Rutherfurrd/Science-Jubilee-Modular-Equipment-System/Todo.txt

Jubilee Presentation:
-3D print control hub housing
-Mill hotplate blanks
-Prep small demo

-Add fan to H&S, 20mm
-Remodel all of H&S
-Refine hotplate
-Finish PCB's
