Rutherfurrd/Science-Jubilee-Modular-Equipment-System/Presentations/Design Review 5-7.pptx

## Heating and Stirring Module Design Review #5

## Heating & Stirring PCB

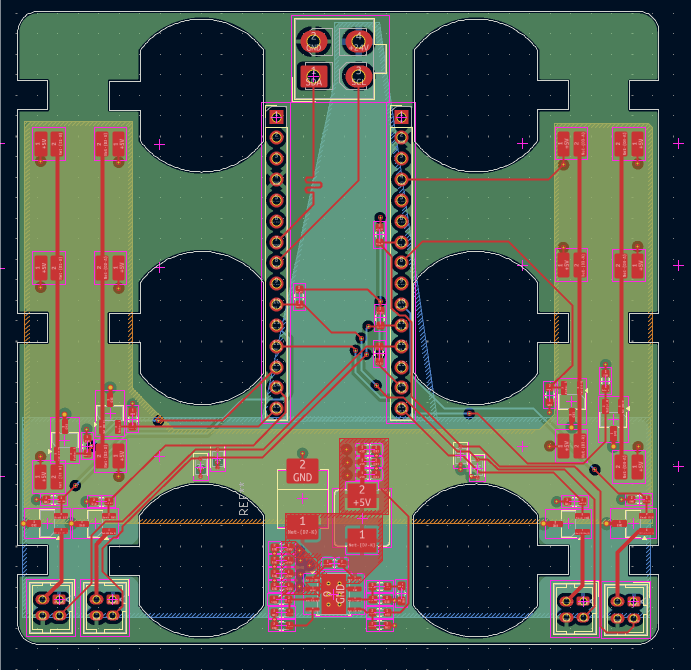
[picture p5: figure]

- Finished routing 4-layer board
- Mainly SMD components, to be assembled by hand
- Designed around NUCLEO-G431KB Development board
- $7 order, 5 board MOQ.

## Heating & Stirring PCB

- Slides directly over motor housing.
- Motor housing requires alteration to account for connector placement.
- Solder pads for motor connection limits repairability, lowers cost.
- Ventilation?
- EMI Concerns

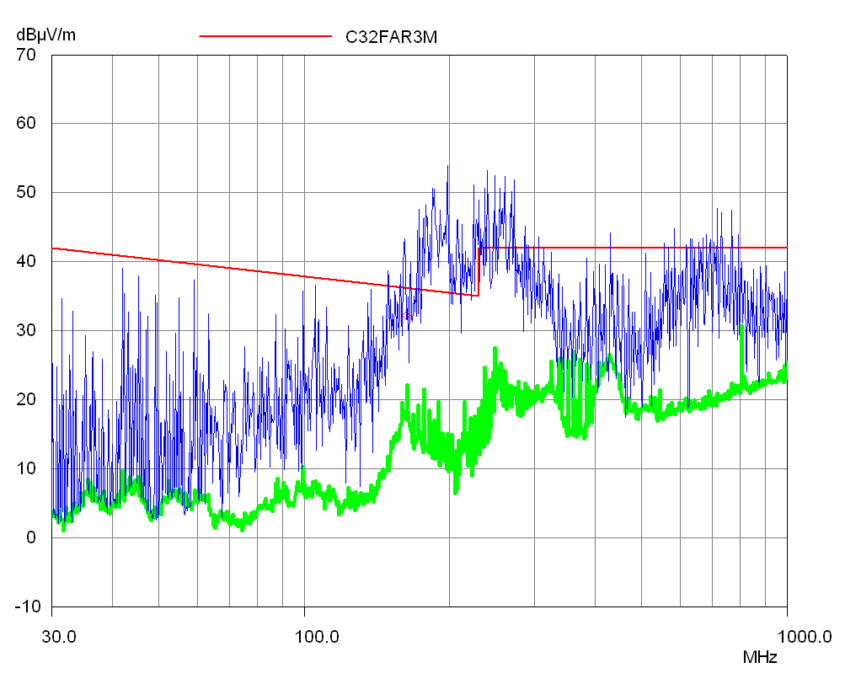
[picture p6: figure]
rf - DC brush motor EMI - Electrical Engineering Stack Exchange
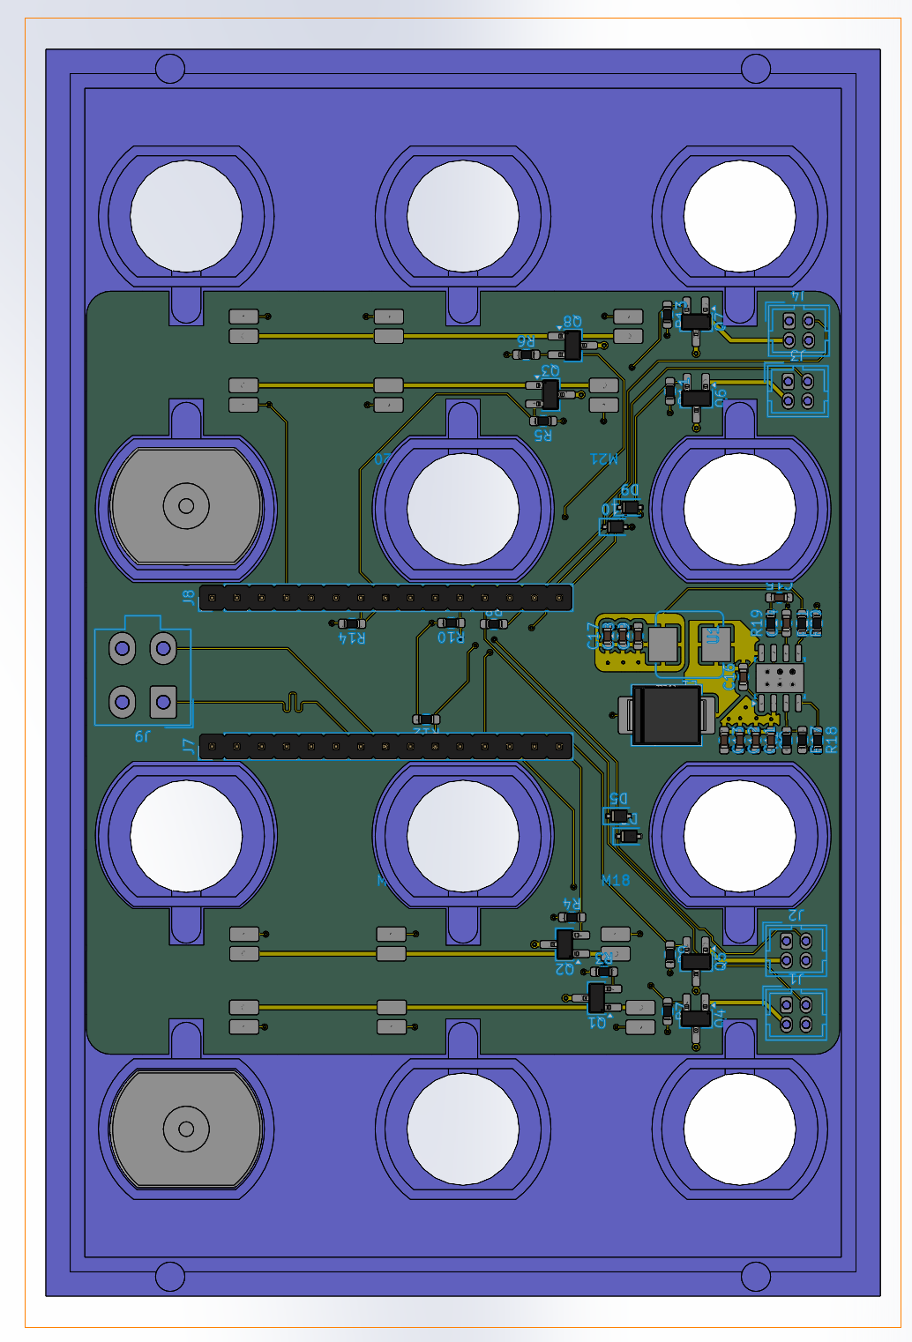
[picture p7: figure]

## Control Hub PCB

- Based on NUCLEO-C071RB development board.
- ~25A max draw, multi-plane power bus.
- Limited power output, ~100W/module fully loaded.
- Fused main and module lines, emergency stop

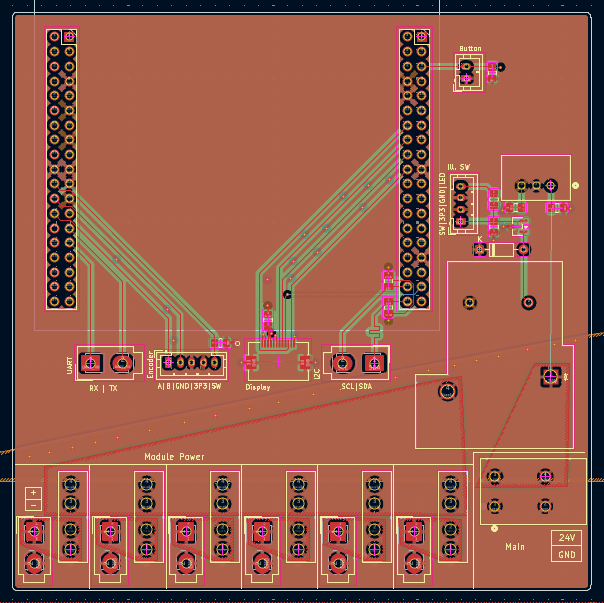
[picture p8: figure]

## Control Hub PCB

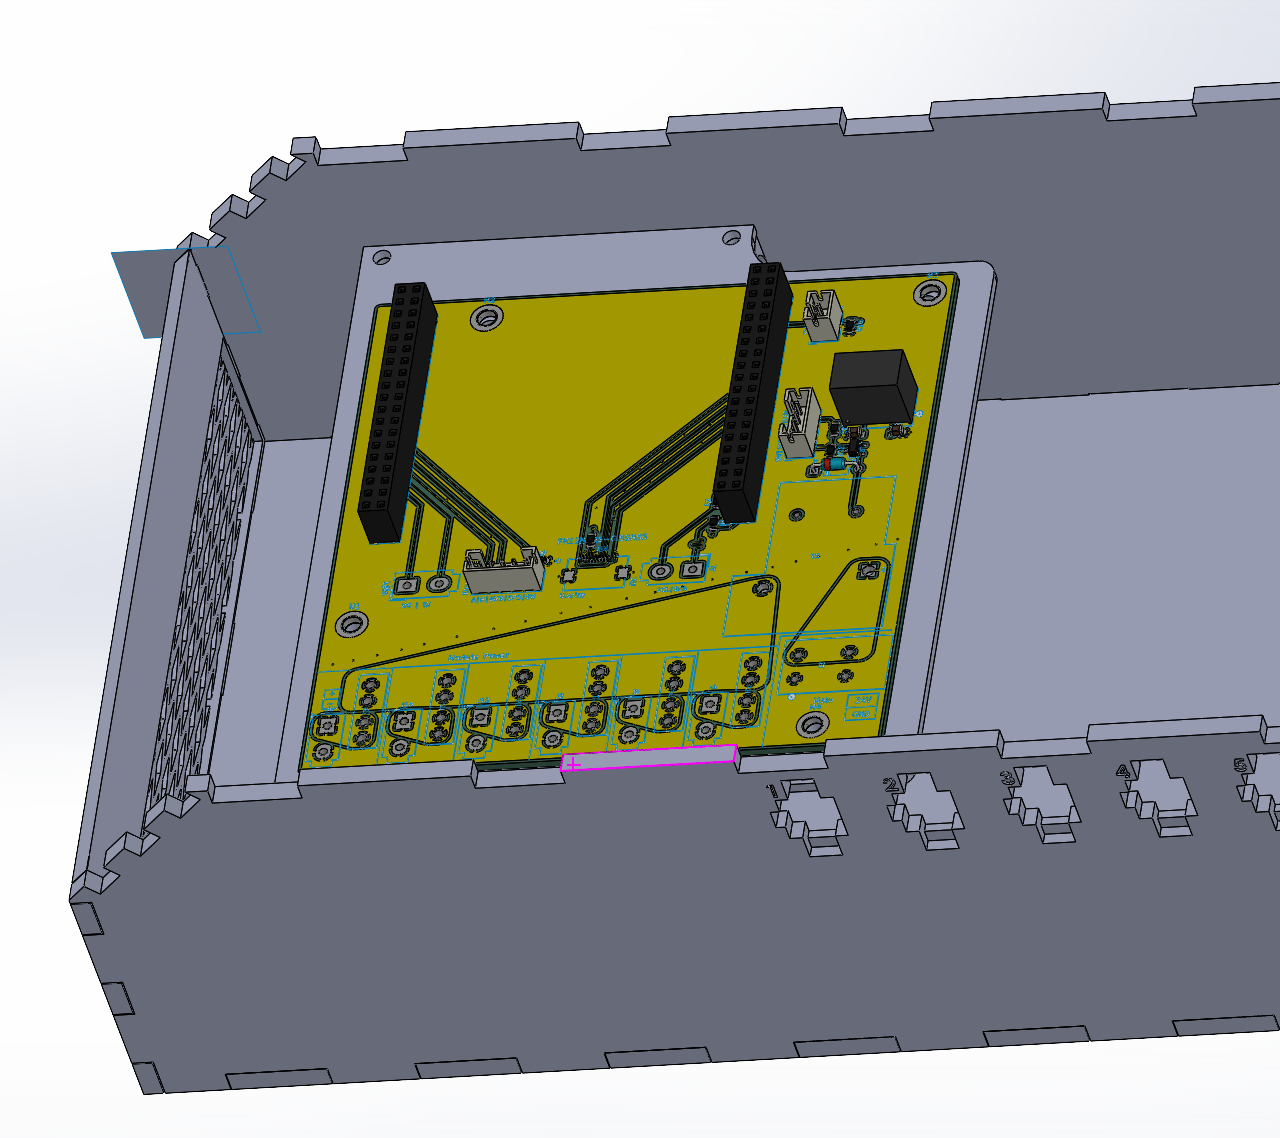
[picture p9: figure]

- Mounting plate, M3 screws + standoffs.
- Terminal-style main connection.
- MCU is over-spec, could be downsized to reduce footprint.

## CAN-Bus vs I2C

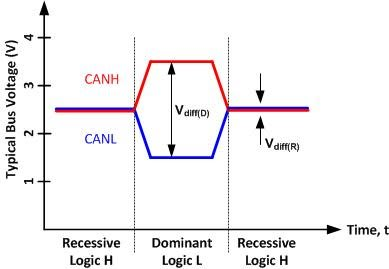
[picture p10: figure]
Introduction | CAN Bus Pt1 | DesignSpark

- H&S modules will be extremely noisy.
- I2C is noise sensitive, resulting in packet loss.
- CAN-Bus is noise resistant by nature.
  - Requires extra IC.
  - Reduces connector positions.
  - Modules can be “chained” together.
  - Slightly slower transmission speeds, negligible in our case.

CAN-BUS Timing Diagram

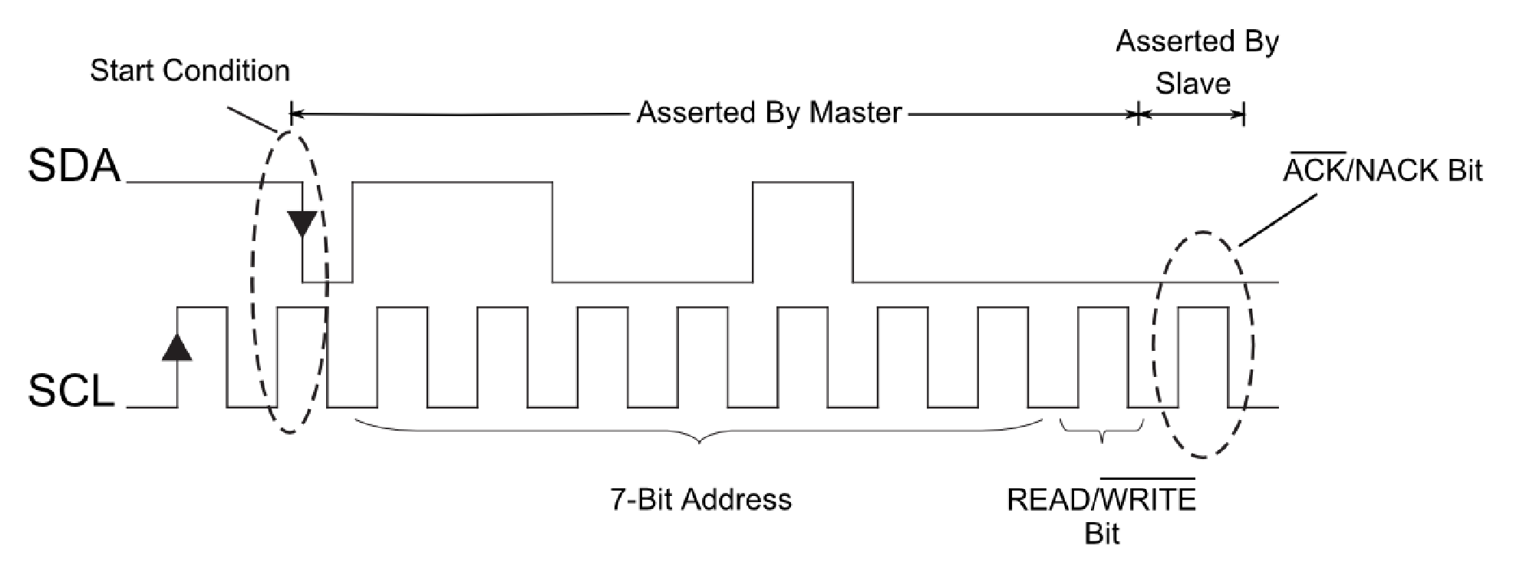
[picture p11: figure]
I2C Primer: What is I2C? (Part 1) | Analog Devices

I2C Timing Diagram

## Next Steps

- Implement CAN-Bus.
  - CAN Transceivers
  - Hot-swappable terminating resistors
- Alter housing to account for PCB changes.
  - Ventilation
  - Connector sizing
  - Button/Screen placement
- Verify high-current design with experienced peers.
