Rutherfurrd/Science-Jubilee-Modular-Equipment-System/Presentations/Design Review 4-16.pptx

## Heating and Stirring Module Design Review #4

## Power Constraints

- Underestimated power requirement of hotplates.
  - 10-25W required, 5W initial estimate.
  - Further testing required.
  - Total power consumption, 450-700W.
- Change from 5V to 24V architecture.
  - Lower transmission losses.
  - Lower current.
  - Requires redesign of current power distribution systems.

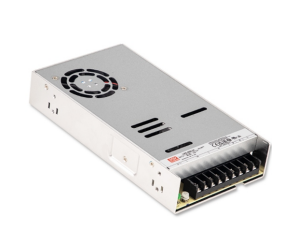
[picture p12: figure]

## Power contd.

- Larger power supply required, increased cost.
  - LRS-600N2, 600W @ 24V, $64. 12% larger footprint.
  - Cannot accommodate a 6-module control hub, 4 at most.
- H&S 24-5V Buck required, increased complexity.

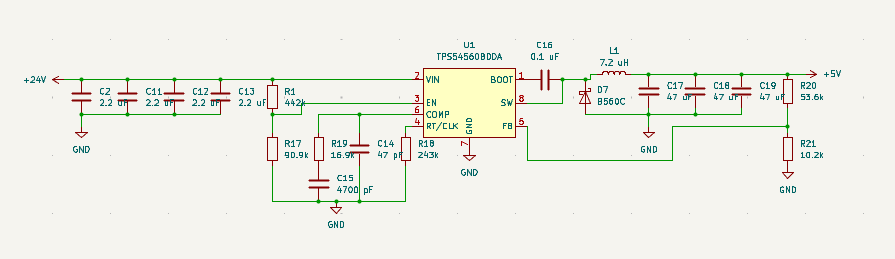
[picture p13: figure]

## Redesigned Hotplate

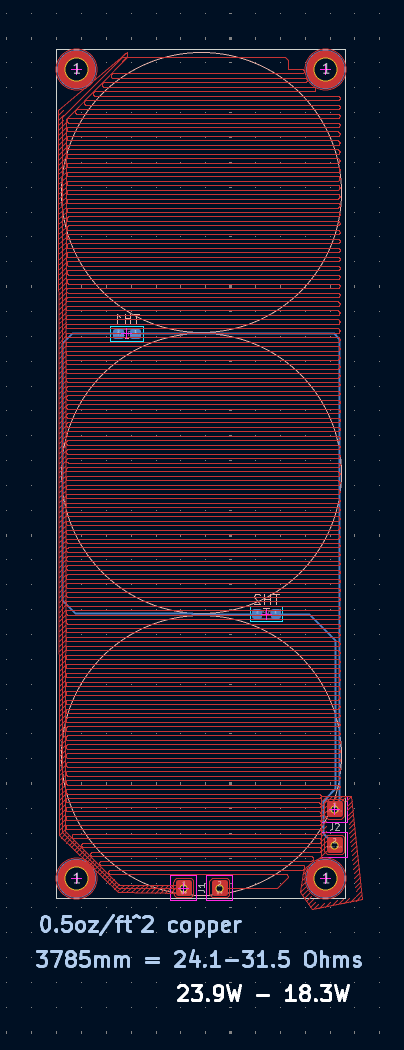
[picture p14: figure]

- Tuned line thickness, routing pattern for:
  - Higher resistance.
  - Output power, 25W goal.
  - Heat dissipation.
  - Thermistor accuracy.

## Adjusted Housing Dimensions

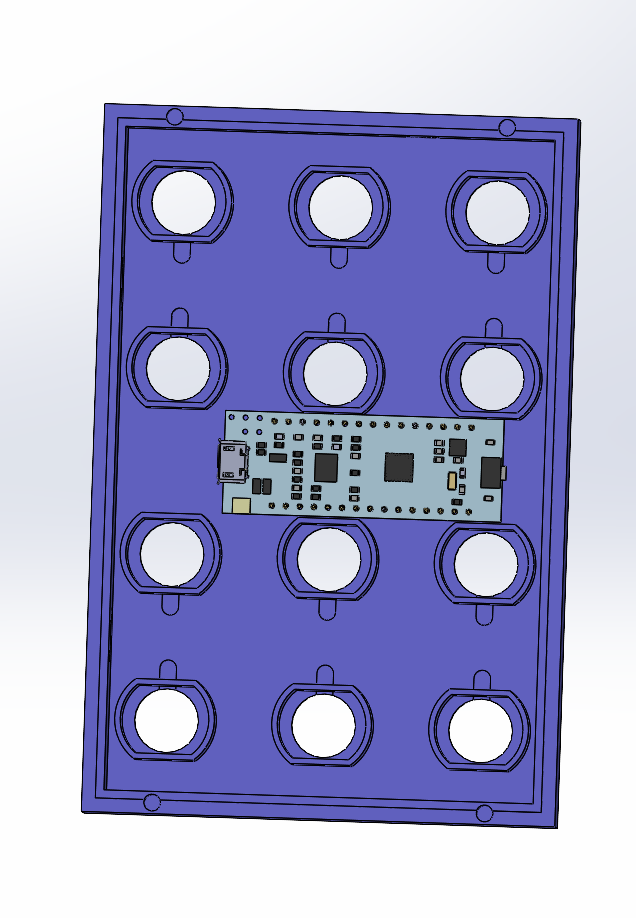
[picture p15: figure]

- Altered motor spacing to accommodate for a Nucleo-32 development board.
- Reduced complexity.
- All housing components must be updated.

## Heating and Stirring PCB

- 75% complete, missing pinouts, several connectors.
- 4-layers, assembled by hand.
- SMD components unavoidable.
- Redesigned power distribution.
  - 24V, 1A hotplate. Main bus.
  - 5V, ~3A total motors. Buck converter.
  - 3.3V, ~400mA logic. Internal LDO VR.

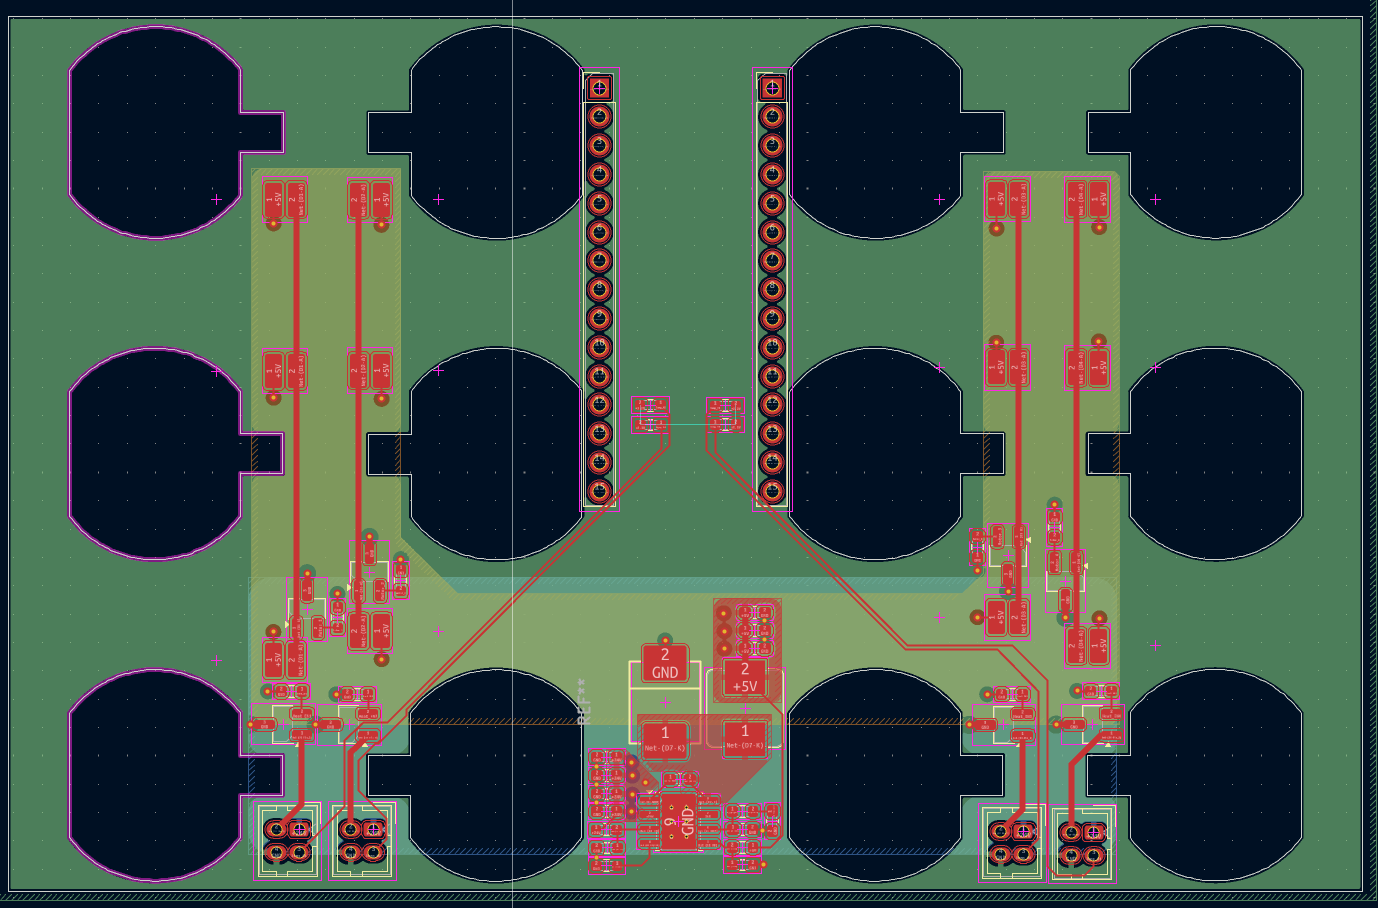
[picture p16: figure]

## Purchasing PCB’s

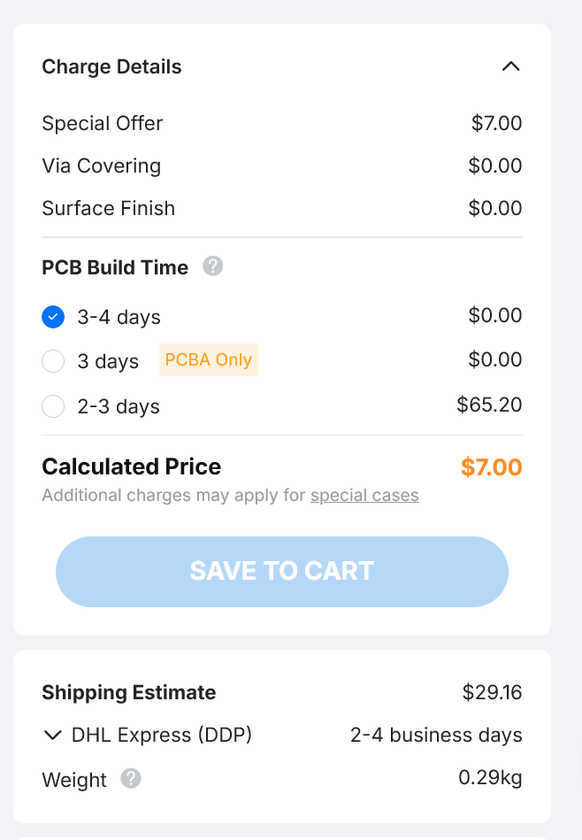
[picture p17: figure]

- Low materials cost
- Customs fee & tariffs ~$40
- Ordering in bulk
- Extensive testing prior to order

## Next Steps

- Finish H&S and Control Hub PCBs.
- Remodel H&S lid and vial guide.
- Remodel Control Hub.
- Test stir bar interaction.
