Rutherfurrd/Science-Jubilee-Modular-Equipment-System/Bill of Materials.xlsx

Sheet: H&S Module
Part | Serial | Link | Quantity | Price
Motor | PPN7PA12C1 | https://www.digikey.com/en/products/detail/nmb-technologies-corporation/PPN7PA12C1/2417079 | 12 | $3.29
Magnet | 9043 | https://www.digikey.com/en/products/detail/radial-magnets-inc/9043/6030788 | 24 | $0.38
Thermistor | ERT-J1VG103FA | https://www.digikey.com/en/products/detail/panasonic-electronic-components/ERT-J1VG103FA/526532
STM32 IO | Thermistor | 4
 | Heat MOSFET | 4
 | Motor mos | 7
 | UART | 2
Connectors
NUCLEO-L432KC (https://www.digikey.com/en/products/detail/stmicroelectronics/NUCLEO-L432KC/6132763)

Sheet: Control Hub
Display | https://www.digikey.com/en/products/detail/az-displays/ATM0130B3/12168269
Disp Conn | https://www.digikey.com/en/products/detail/hirose-electric-co-ltd/FH12-12S-0-5SH-55/1110374
Power Supply | LRS-200-5
AC Socket | DC11.0001.003 | https://www.digikey.com/en/products/detail/schurter-inc/DC11-0001-003/641544
Fan |  | https://www.digikey.com/en/products/detail/sunon-fans/MF40100V1-1000U-A99/6198732
2x2 Conn |  | https://www.digikey.com/en/products/detail/molex/0039012041/61227
USB |  | https://www.aliexpress.us/item/3256807073804695.html?gatewayAdapt=glo2usa
3-state SW |  | https://www.digikey.com/en/products/detail/adam-tech/SW-T2-2E-A-A2-M1/15284450
Switch |  | https://www.digikey.com/en/products/detail/e-switch/PS1024ARED/44577
Ill on/off SW |  | https://switches-sensors.zf.com/wp-content/uploads/2024/08/Rocker_SRB_Datasheet_2024-08-02.pdf
LED | 3mm diam

Sheet: Sheet2
Voltage (V) | 5
# of Modules | 6
 | Quantity | Component Current | Module Current | Module Power | Total Power
Motor | 12 | 0.235 | 2.82 | 14.1 | 84.6
Hotplate | 4 | 2.994011976 | 11.9760479 | 60 | 360
 |  |  |  | Total Power: | 444.6
 |  |  |  | Current: | 88.92
