Rutherfurrd/Science-Jubilee-Modular-Equipment-System/3D Files/Control Hub/Assembly/Assembly.SLDASM

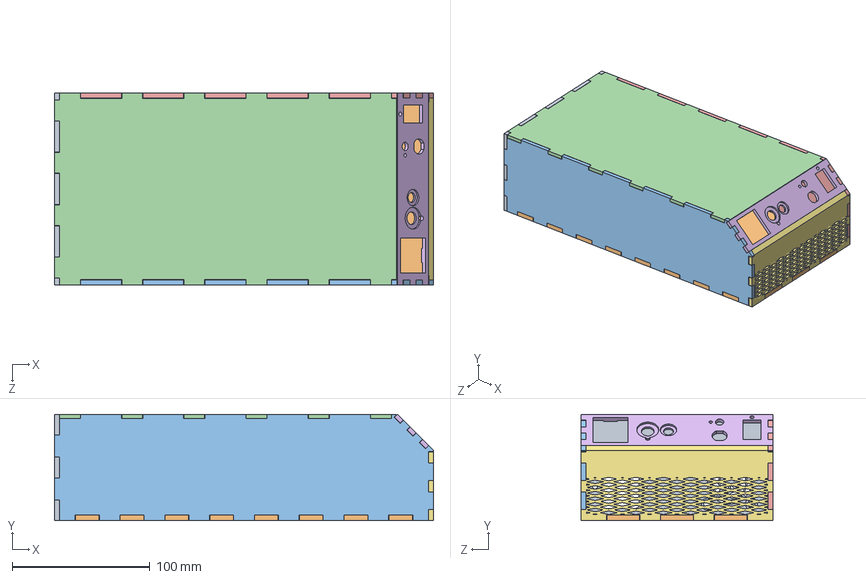
[picture p37: CAD file, 2026-05-28]
3D Files/Control Hub/Assembly/Assembly.SLDASM
275.0 x 77.2 x 139.0 mm
Tab and Slot-Tab20
Boss-Extrude11
Tab and Slot-Slot19
Tab and Slot-Tab21
Tab and Slot-Slot20
Tab and Slot-Slot11
Tab and Slot-Slot21
