Rutherfurrd/Science-Jubilee-Modular-Equipment-System/3D Files/Control Hub/Assembly/Tab and Slot-Slot21.SLDPRT

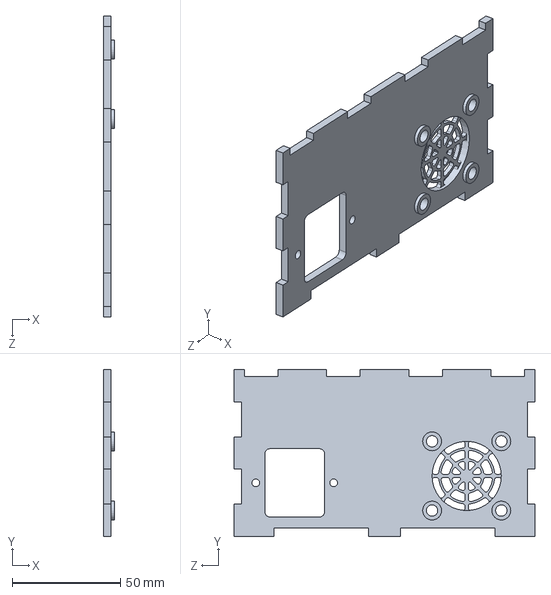
[picture p38: CAD file, 2026-05-28]
3D Files/Control Hub/Assembly/Tab and Slot-Slot21.SLDPRT
5.00 x 77.2 x 139.0 mm
