Rutherfurrd/Science-Jubilee-Modular-Equipment-System/3D Files/Control Hub/Print Files/Right Side Panel.STL

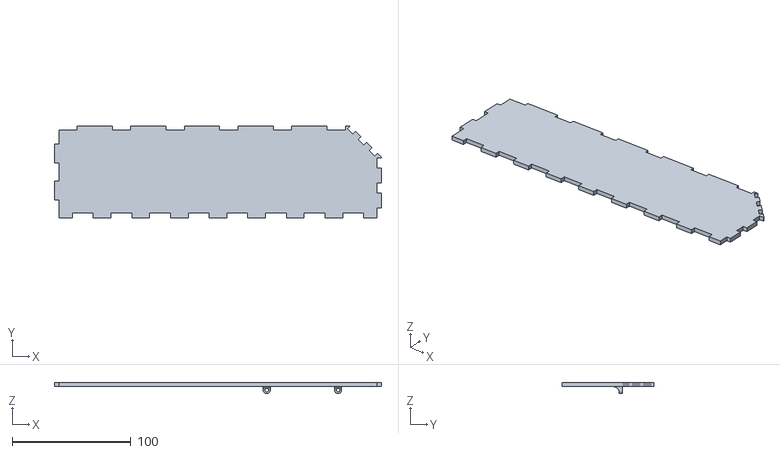
[picture p39: CAD file, 2026-05-28]
3D Files/Control Hub/Print Files/Right Side Panel.STL
275.0 x 77.2 x 9.50
