Rutherfurrd/Science-Jubilee-Modular-Equipment-System/3D Files/Control Hub/Tab and Slot-Slot19.SLDPRT

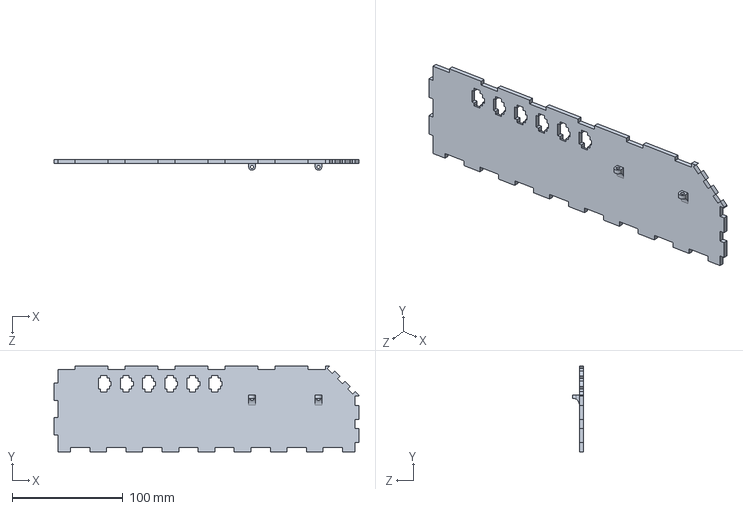
[picture p40: CAD file, 2026-05-28]
3D Files/Control Hub/Tab and Slot-Slot19.SLDPRT
275.0 x 77.2 x 9.50 mm
