Rutherfurrd/Science-Jubilee-Modular-Equipment-System/3D Files/H&S/Motor Base.SLDPRT

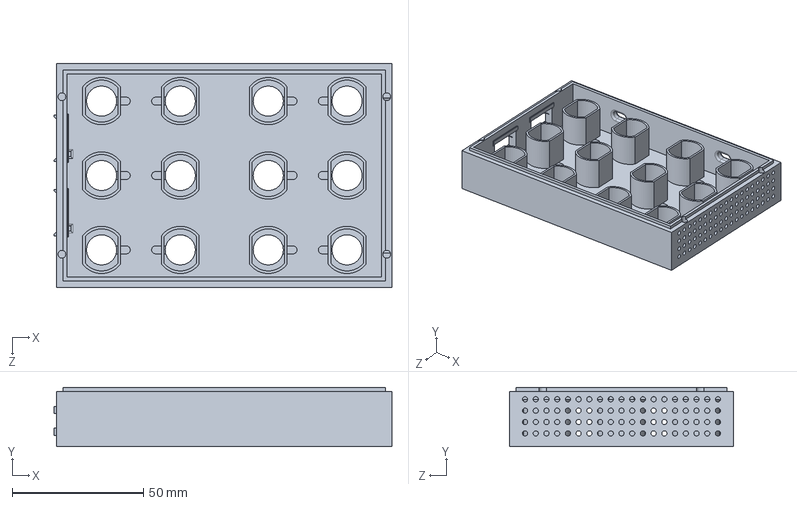
[picture p41: CAD file, 2026-05-28]
3D Files/H&S/Motor Base.SLDPRT
128.8 x 22.5 x 85.5 mm
