Rutherfurrd/Science-Jubilee-Modular-Equipment-System/3D Files/H&S/Print Files/Hotplate Stud.STL

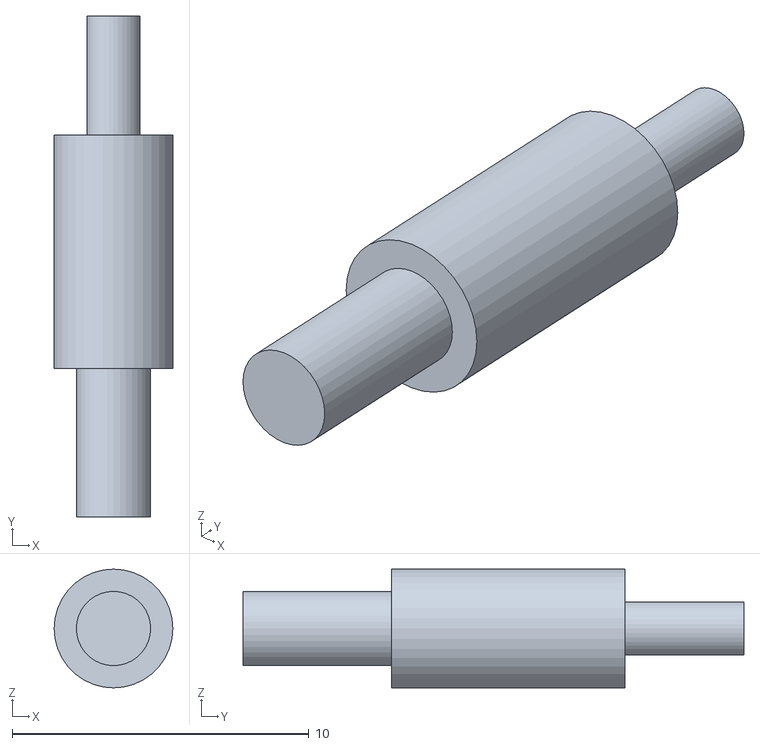
[picture p42: CAD file, 2026-05-28]
3D Files/H&S/Print Files/Hotplate Stud.STL
4.00 x 16.9 x 4.00
