Rutherfurrd/Science-Jubilee-Modular-Equipment-System/3D Files/Milling/PCB.step

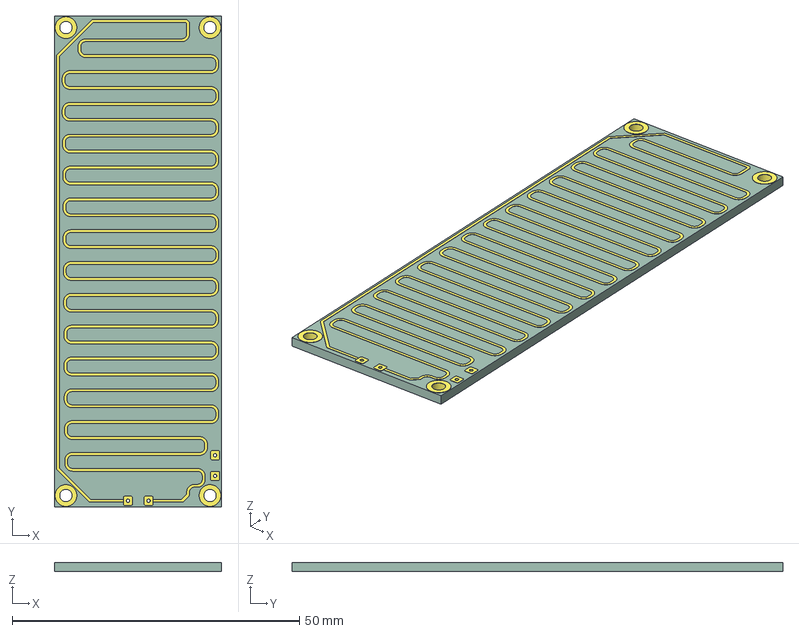
[picture p43: CAD file, 2026-05-28]
3D Files/Milling/PCB.step
29.1 x 85.5 x 1.59 mm
Heating board - Copy_copper
Heating board - Copy_pad
Heating board - Copy_PCB
