Rutherfurrd/Science-Jubilee-Modular-Equipment-System/Electrical Files/H&S Module/PCB.step

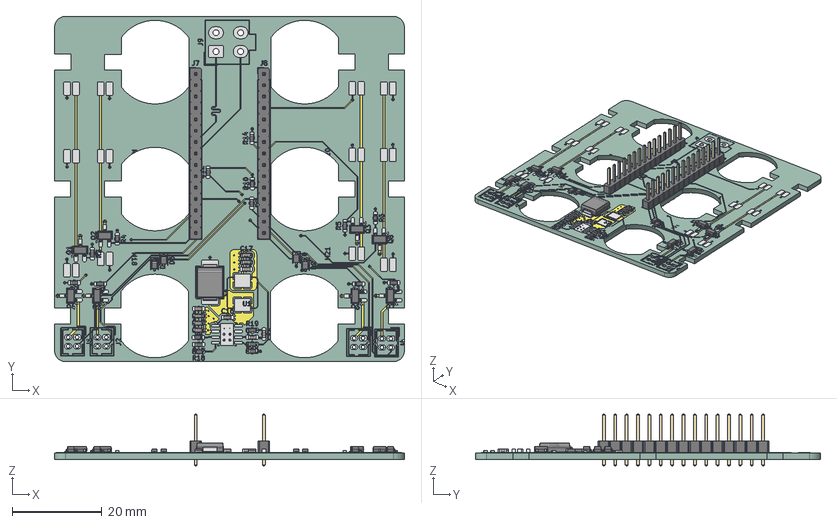
[picture p44: CAD file, 2026-05-28]
Electrical Files/H&S Module/PCB.step
78.2 x 77.2 x 11.5 mm
R_0603_1608Metric x 18
SC-59 x 8
SMC_L7.1-W6.2-LS8.1-R-RD
C_0603_1608Metric x 10
PinHeader_1x15_P2.54mm_Vertical x 2
D_SOD-323F x 4
S&H Management board_copper
S&H Management board_pad
S&H Management board_via
S&H Management board_silkscreen
S&H Management board_PCB
