Rutherfurrd/Science-Jubilee-Modular-Equipment-System/Electrical Files/Hotplate/Heating board.step

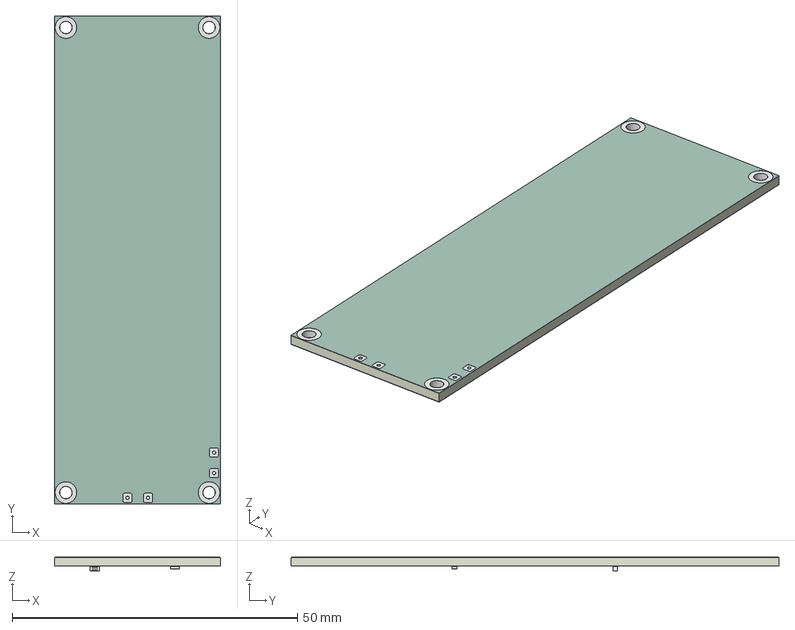
[picture p45: CAD file, 2026-05-28]
Electrical Files/Hotplate/Heating board.step
29.1 x 85.5 x 2.45 mm
C_0603_1608Metric
R_0603_1608Metric
Heating board_copper
Heating board_pad
Heating board_silkscreen
Heating board_soldermask x 2
Heating board_PCB
