Rutherfurrd/Science-Jubilee-Modular-Equipment-System/Electrical Files/Hotplate/JLCFH/JLC Stencil.DXF

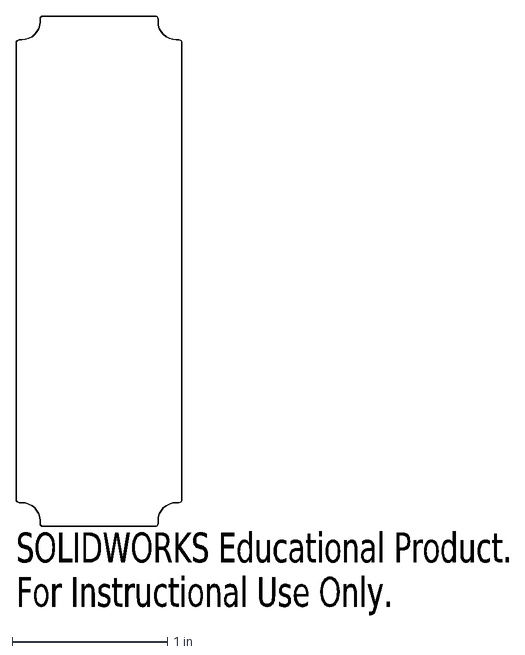
[picture p46: CAD file, 2026-05-28]
Electrical Files/Hotplate/JLCFH/JLC Stencil.DXF
SOLIDWORKS Educational Product.
For Instructional Use Only.
