Rutherfurrd/Science-Jubilee-Modular-Equipment-System/Electrical Files/PS Control Hub/PS Control Hub/PCB.step

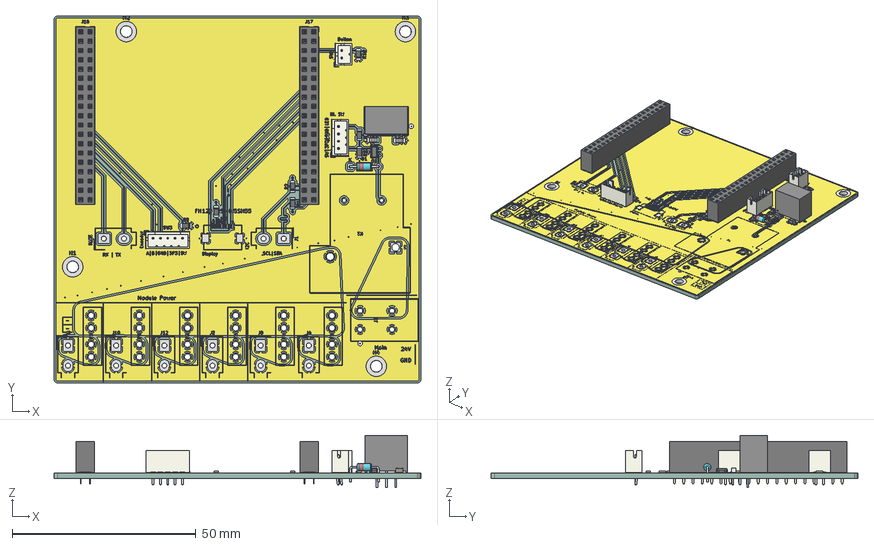
[picture p47: CAD file, 2026-05-28]
Electrical Files/PS Control Hub/PS Control Hub/PCB.step
100.0 x 100.0 x 14.3 mm
R_0805_2012Metric x 7
C_0805_2012Metric x 2
JST_PH_B4B-PH-K_1x04_P2.00mm_Vertical
JST_PH_B2B-PH-K_1x02_P2.00mm_Vertical
D_DO-35_SOD27_P7.62mm_Horizontal
SOT-23-3
JST_PH_B5B-PH-K_1x05_P2.00mm_Vertical
PinSocket_2x19_P2.54mm_Vertical x 2
TSR 1-2433E
PS Control Hub_copper
PS Control Hub_pad
PS Control Hub_via
PS Control Hub_silkscreen x 2
PS Control Hub_PCB
