Rutherfurrd/Science-Jubilee-Modular-Equipment-System/3D Files/H&S/Print Files/PCB - PCB.step-1 Heating board - Copy_PCB.step-1.STL

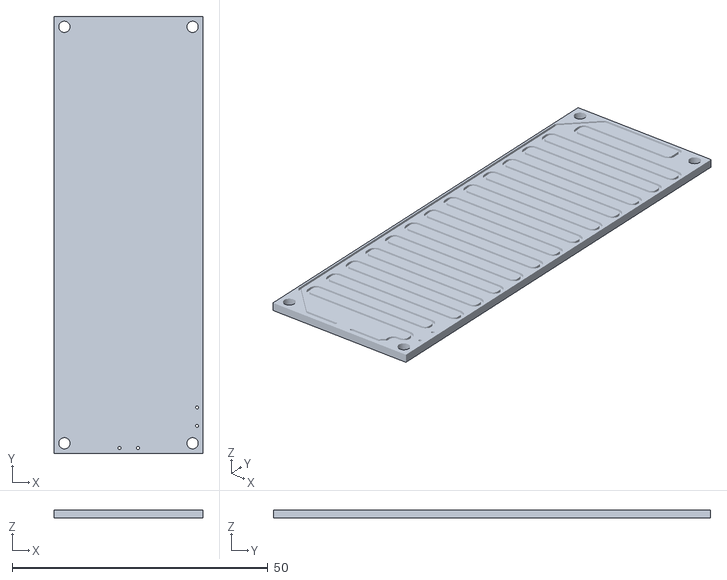
[picture p49: CAD file, 2026-05-28]
3D Files/H&S/Print Files/PCB - PCB.step-1 Heating board - Copy_PCB.step-1.STL
29.1 x 85.5 x 1.51
