Rutherfurrd/Science-Jubilee-Modular-Equipment-System/Electrical Files/H&S Module/Motor Base.DXF

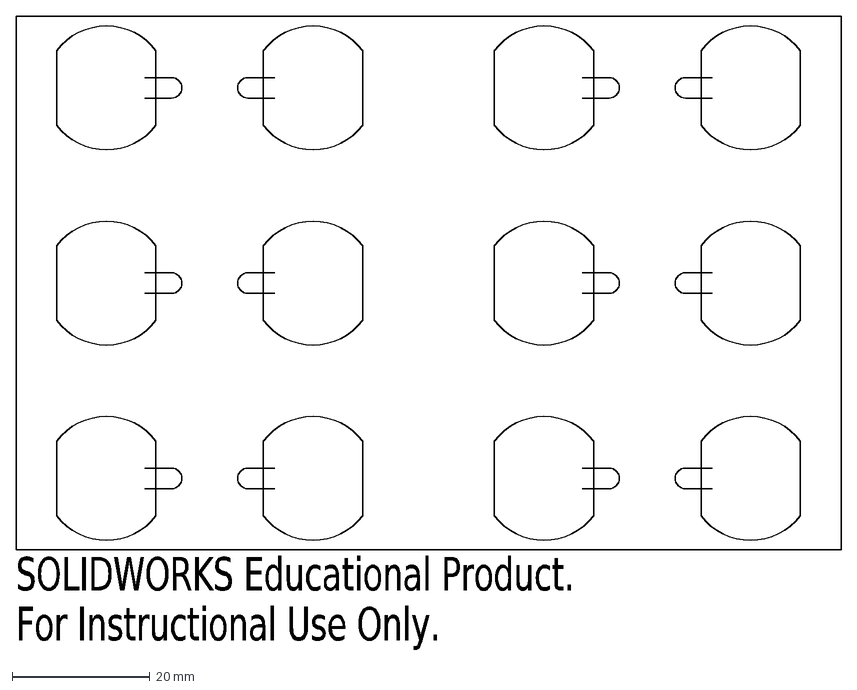
[picture p50: CAD file, 2026-04-16]
Electrical Files/H&S Module/Motor Base.DXF
SOLIDWORKS Educational Product.
For Instructional Use Only.
