Rutherfurrd/Science-Jubilee-Modular-Equipment-System/Electrical Files/Hotplate/JLCFH/JLC Step.step

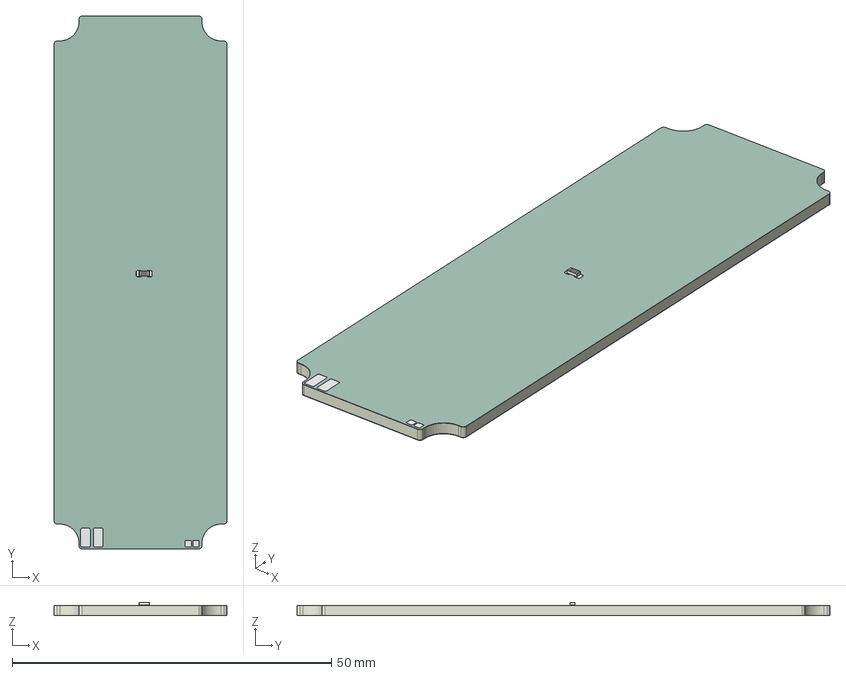
[picture p51: CAD file, 2026-05-28]
Electrical Files/Hotplate/JLCFH/JLC Step.step
27.1 x 83.5 x 2.09 mm
R_0603
Flexible Heater_pad
Flexible Heater_soldermask x 2
Flexible Heater_PCB
