Rutherfurrd/Science-Jubilee-Modular-Equipment-System/3D Files/Control Hub/Print Files/Button Interface.STL

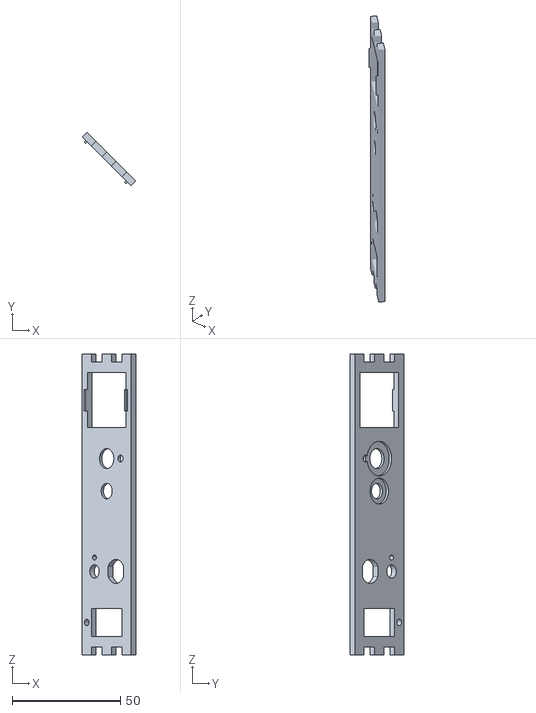
[picture p52: CAD file, 2026-05-28]
3D Files/Control Hub/Print Files/Button Interface.STL
24.7 x 24.7 x 139.0
