Rutherfurrd/Science-Jubilee-Modular-Equipment-System/3D Files/Control Hub/Tab and Slot-Tab21.SLDPRT

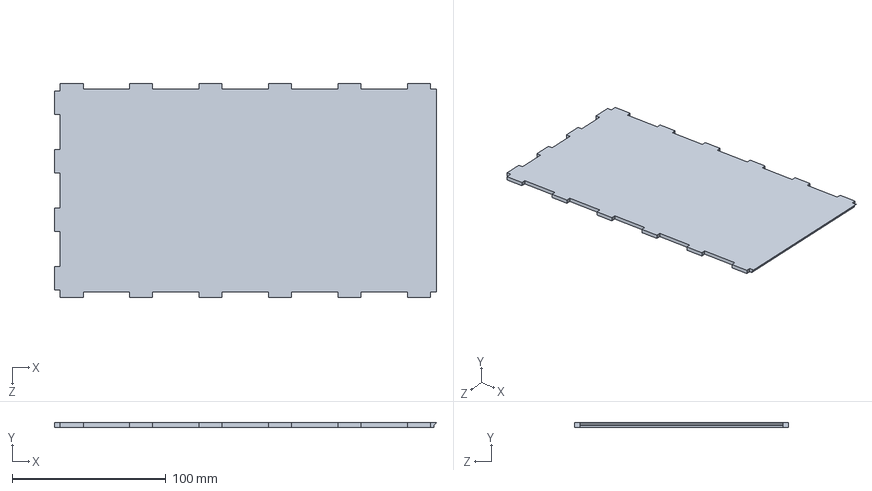
[picture p53: CAD file, 2026-05-28]
3D Files/Control Hub/Tab and Slot-Tab21.SLDPRT
248.2 x 3.00 x 139.0 mm
