Rutherfurrd/Science-Jubilee-Modular-Equipment-System/3D Files/H&S/Print Files/Test Well.STL

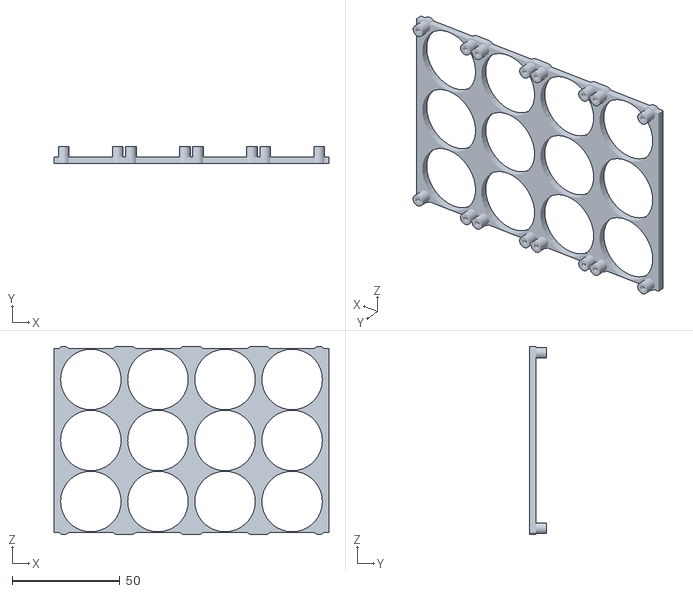
[picture p54: CAD file, 2026-05-28]
3D Files/H&S/Print Files/Test Well.STL
127.8 x 8.00 x 87.5
