Rutherfurrd/Science-Jubilee-Modular-Equipment-System/3D Files/Control Hub/Print Files/Front Grille.STL

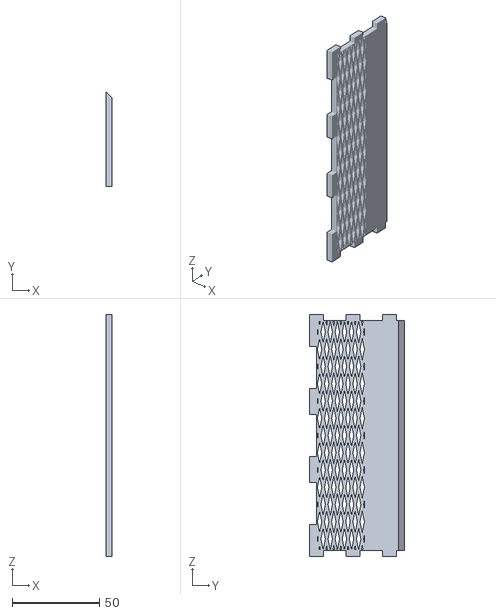
[picture p55: CAD file, 2026-05-28]
3D Files/Control Hub/Print Files/Front Grille.STL
3.50 x 54.5 x 139.0
