Rutherfurrd/Science-Jubilee-Modular-Equipment-System/3D Files/H&S/Magnet Case.SLDPRT

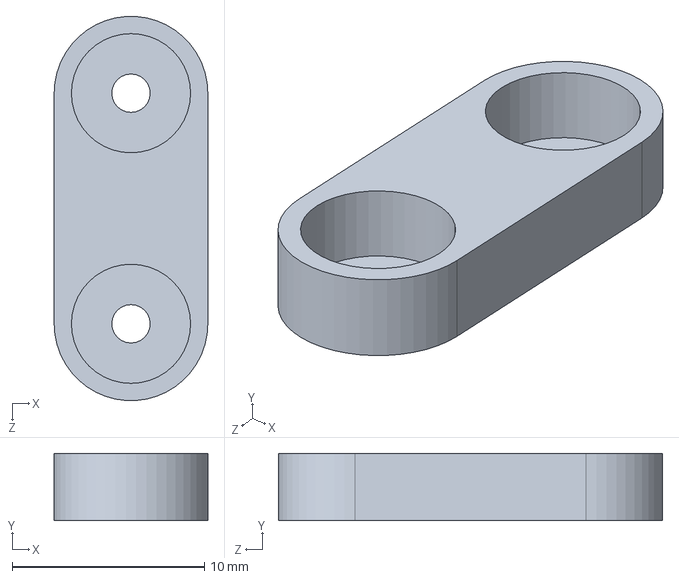
[picture p56: CAD file, 2026-05-28]
3D Files/H&S/Magnet Case.SLDPRT
8.00 x 3.50 x 20.0 mm
