Rutherfurrd/Science-Jubilee-Modular-Equipment-System/3D Files/H&S/Print Files/Test LID.STL

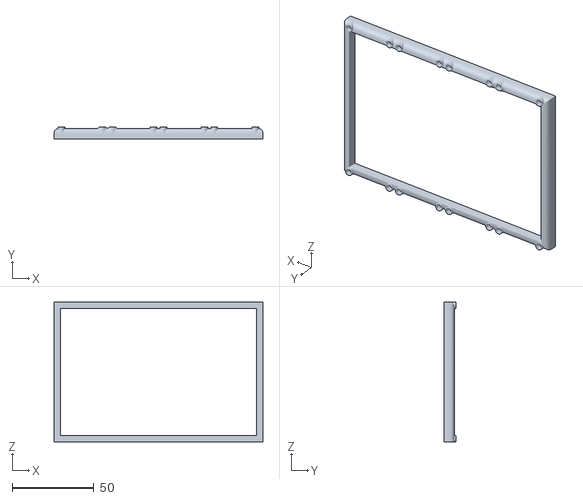
[picture p57: CAD file, 2026-05-28]
3D Files/H&S/Print Files/Test LID.STL
127.8 x 7.50 x 85.5
