Rutherfurrd/Science-Jubilee-Modular-Equipment-System/3D Files/Control Hub/Power Supply Chassis.SLDPRT

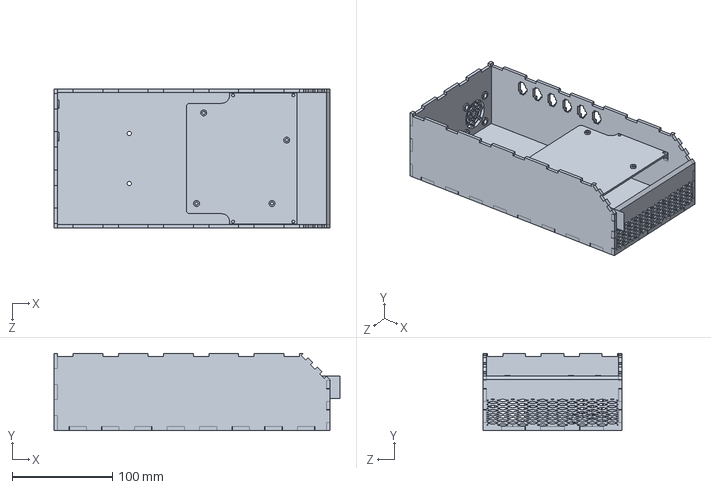
[picture p58: CAD file, 2026-05-28]
3D Files/Control Hub/Power Supply Chassis.SLDPRT
285.0 x 77.2 x 139.0 mm
