Rutherfurrd/Science-Jubilee-Modular-Equipment-System/3D Files/Control Hub/Print Files/Bottom Panel.STL

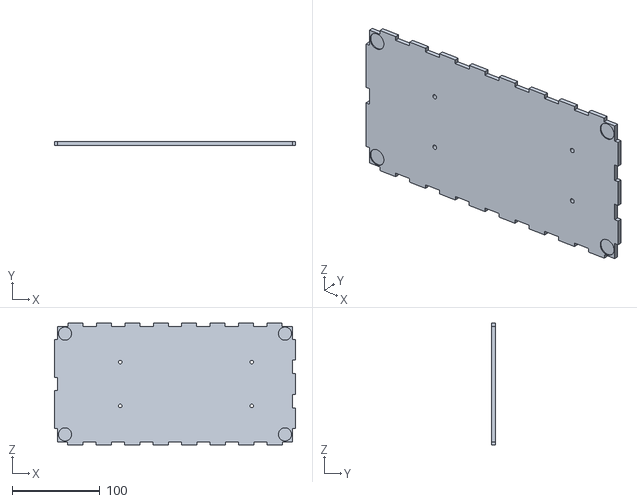
[picture p59: CAD file, 2026-05-28]
3D Files/Control Hub/Print Files/Bottom Panel.STL
275.0 x 4.00 x 139.0
