Rutherfurrd/Science-Jubilee-Modular-Equipment-System/3D Files/H&S/Print Files/PCB - PCB.step-1 Heating board - Copy_copper.step-1.STL

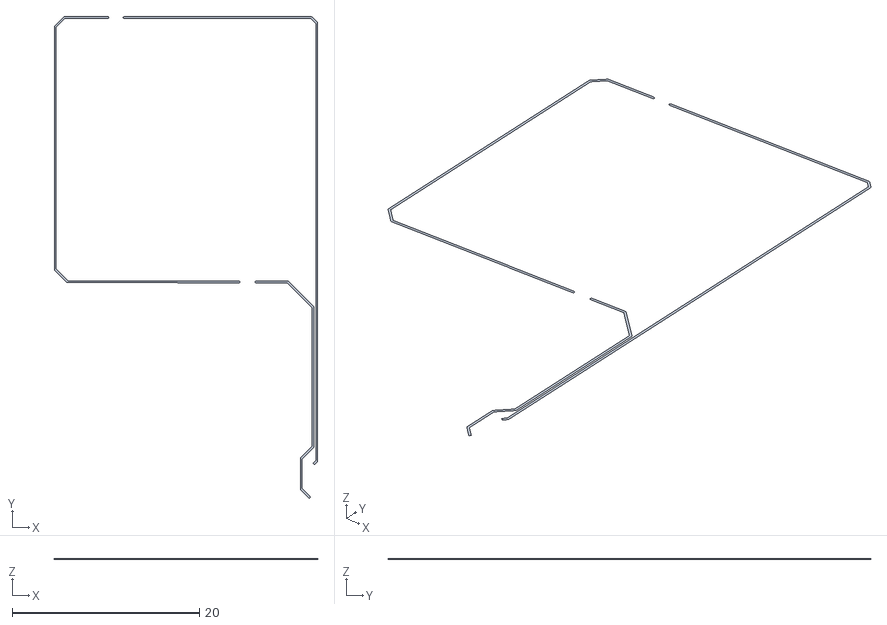
[picture p60: CAD file, 2026-05-28]
3D Files/H&S/Print Files/PCB - PCB.step-1 Heating board - Copy_copper.step-1.STL
28.1 x 51.4 x 0.035
