Rutherfurrd/Science-Jubilee-Modular-Equipment-System/3D Files/H&S/Print Files/PCB - PCB.step-1 Heating board - Copy_pad.step-1.STL

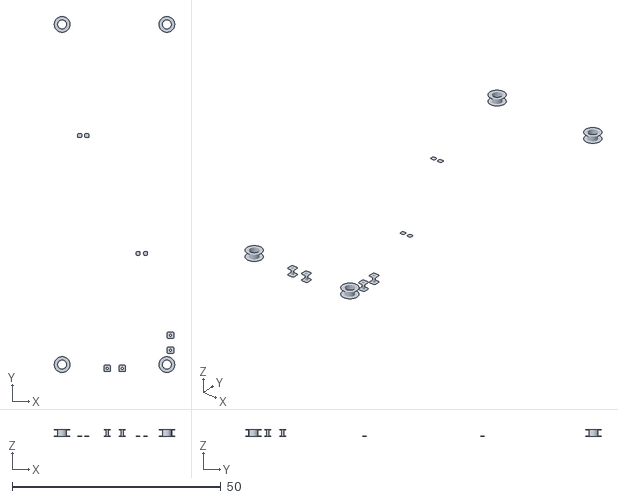
[picture p62: CAD file, 2026-05-28]
3D Files/H&S/Print Files/PCB - PCB.step-1 Heating board - Copy_pad.step-1.STL
28.9 x 85.3 x 1.59
