Rutherfurrd/Science-Jubilee-Modular-Equipment-System/3D Files/Control Hub/Tab and Slot-Slot11.SLDPRT

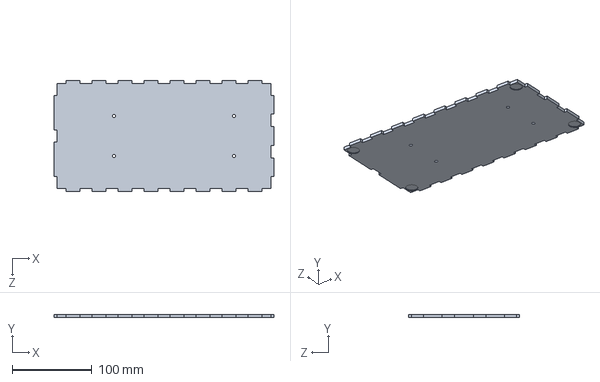
[picture p63: CAD file, 2026-05-28]
3D Files/Control Hub/Tab and Slot-Slot11.SLDPRT
275.0 x 4.00 x 139.0 mm
