Rutherfurrd/Science-Jubilee-Modular-Equipment-System/3D Files/Control Hub/Body2.SLDPRT

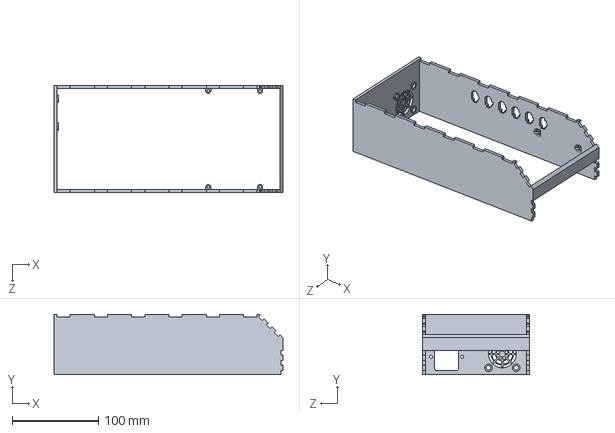
[picture p64: CAD file, 2026-04-16]
3D Files/Control Hub/Body2.SLDPRT
265.0 x 70.0 x 124.0 mm
