Rutherfurrd/Science-Jubilee-Modular-Equipment-System/3D Files/H&S/Motor.SLDPRT

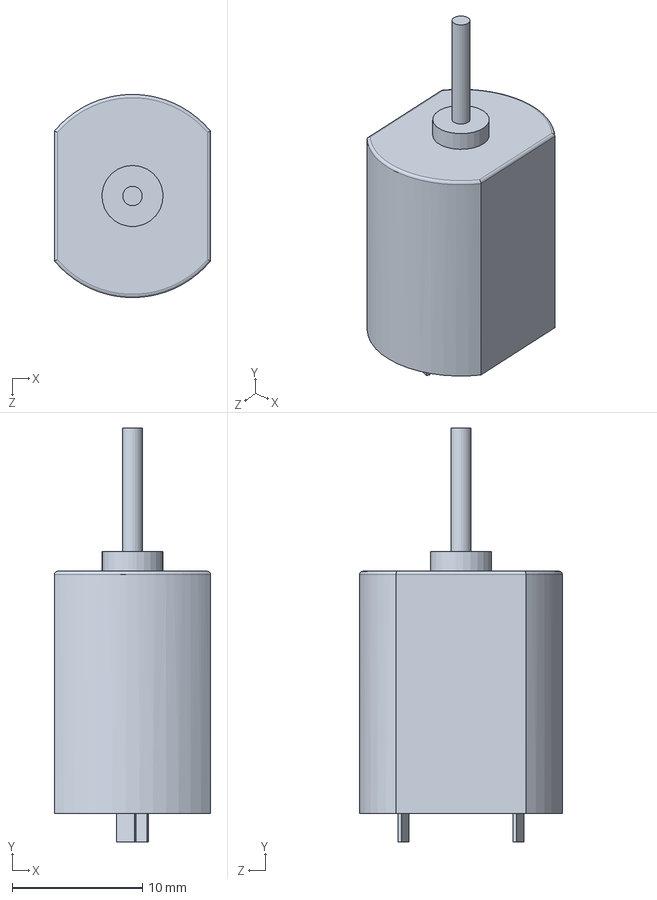
[picture p65: CAD file, 2026-03-10]
3D Files/H&S/Motor.SLDPRT
12.0 x 31.8 x 15.6 mm
