Rutherfurrd/Science-Jubilee-Modular-Equipment-System/3D Files/H&S/Magnet.SLDPRT

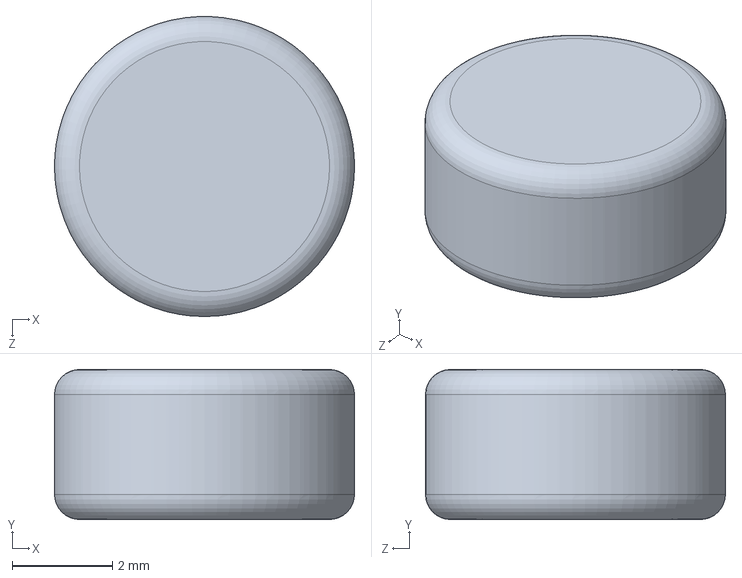
[picture p67: CAD file, 2026-03-10]
3D Files/H&S/Magnet.SLDPRT
6.00 x 3.00 x 6.00 mm
