Rutherfurrd/Science-Jubilee-Modular-Equipment-System/3D Files/Control Hub/Body1.SLDPRT

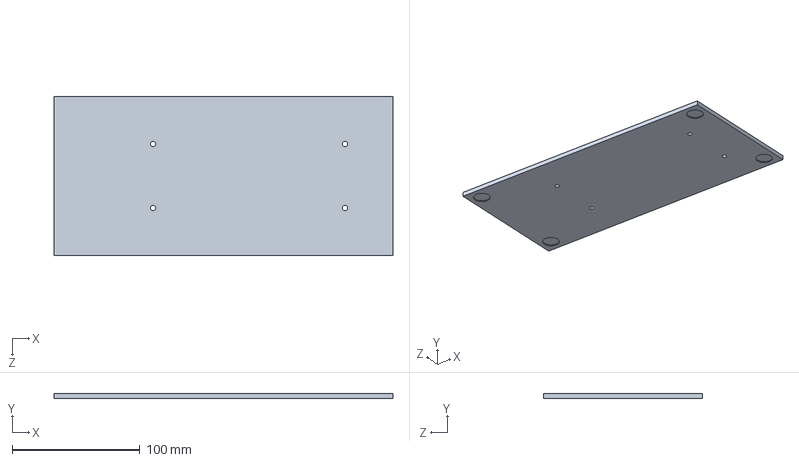
[picture p68: CAD file, 2026-04-16]
3D Files/Control Hub/Body1.SLDPRT
265.0 x 4.00 x 124.0 mm
