Rutherfurrd/Science-Jubilee-Modular-Equipment-System/3D Files/H&S/Heating pad.SLDPRT

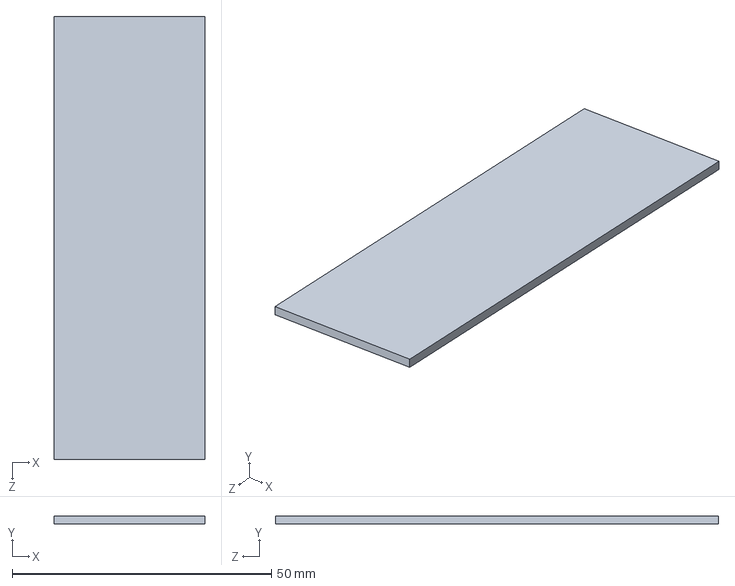
[picture p69: CAD file, 2026-03-10]
3D Files/H&S/Heating pad.SLDPRT
29.1 x 1.60 x 85.5 mm
