Rutherfurrd/Science-Jubilee-Modular-Equipment-System/3D Files/Control Hub/Body4.SLDPRT

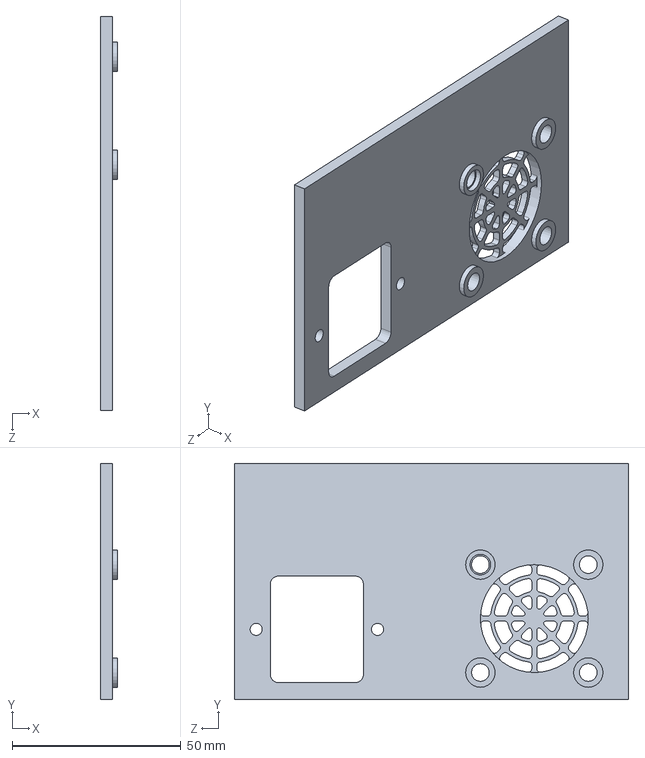
[picture p70: CAD file, 2026-04-16]
3D Files/Control Hub/Body4.SLDPRT
5.00 x 70.0 x 117.0 mm
