Rutherfurrd/Science-Jubilee-Modular-Equipment-System/3D Files/H&S/Motor Housing LID.SLDPRT

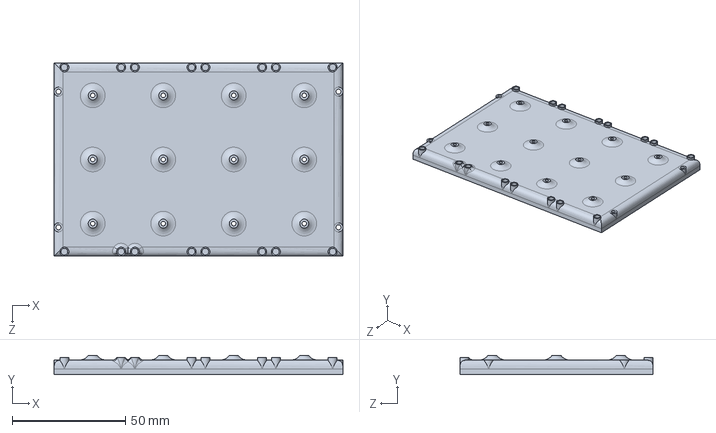
[picture p71: CAD file, 2026-03-10]
3D Files/H&S/Motor Housing LID.SLDPRT
127.8 x 8.50 x 85.5 mm
