Rutherfurrd/Science-Jubilee-Modular-Equipment-System/3D Files/Control Hub/Body9.SLDPRT

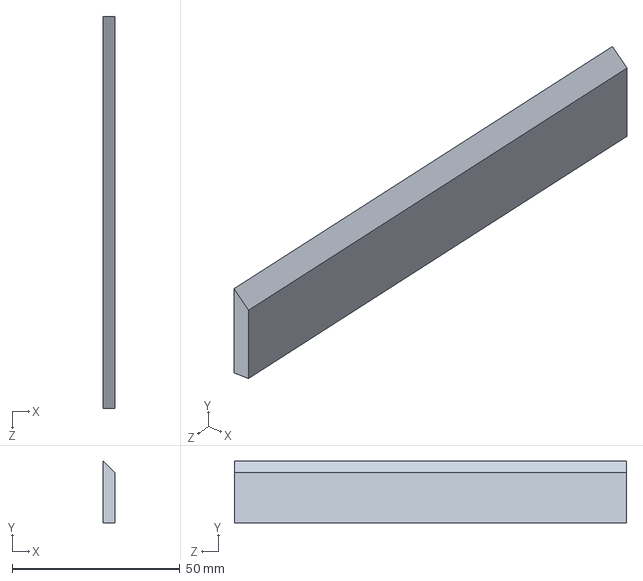
[picture p72: CAD file, 2026-04-16]
3D Files/Control Hub/Body9.SLDPRT
3.50 x 18.5 x 117.0 mm
