Rutherfurrd/Science-Jubilee-Modular-Equipment-System/3D Files/H&S/Vial Wells.SLDPRT

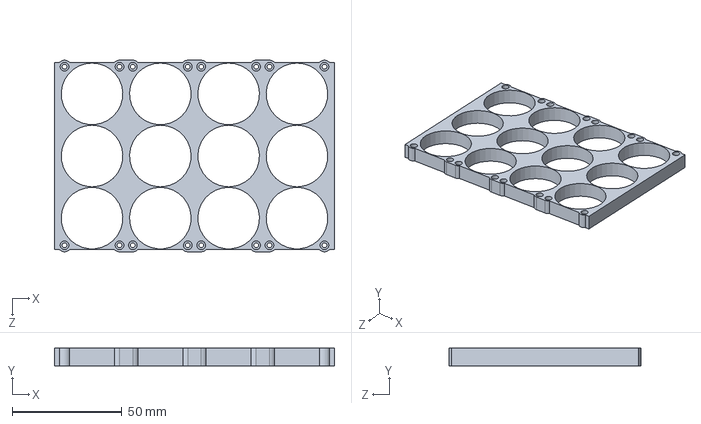
[picture p73: CAD file, 2026-03-10]
3D Files/H&S/Vial Wells.SLDPRT
127.8 x 8.00 x 87.5 mm
