Rutherfurrd/Science-Jubilee-Modular-Equipment-System/3D Files/Control Hub/Body10.SLDPRT

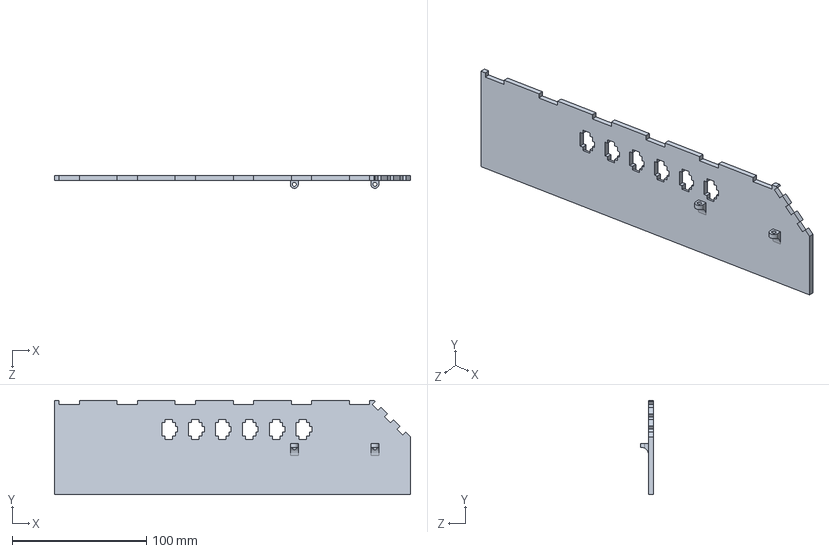
[picture p74: CAD file, 2026-04-16]
3D Files/Control Hub/Body10.SLDPRT
265.0 x 70.0 x 9.50 mm
