Rutherfurrd/Science-Jubilee-Modular-Equipment-System/3D Files/H&S/FinalAssemblyV2.SLDASM

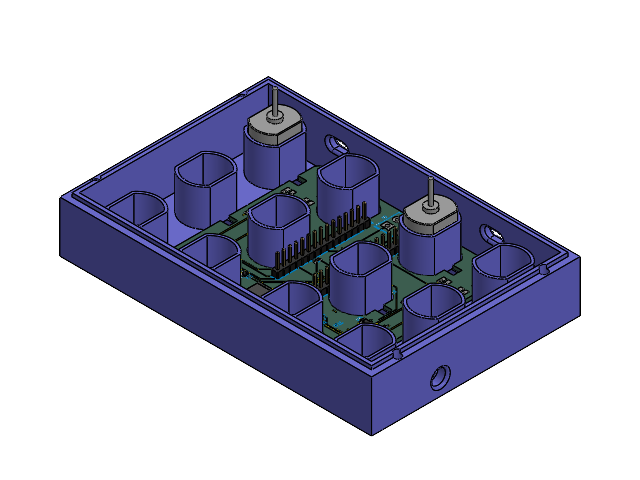
[picture p75: CAD file, 2026-05-28]
3D Files/H&S/FinalAssemblyV2.SLDASM
Motor Base
Motor x 2
R_0603_1608Metric_1.step x 18
SC-59.step x 8
SMC_L7.1-W6.2-LS8.1-R-RD.step
C_0603_1608Metric_1.step x 10
PinHeader_1x15_P2.54mm_Vertical.step x 2
D_SOD-323F.step x 4
S&H Management board_copper.step
S&H Management board_pad.step
S&H Management board_via.step
S&H Management board_silkscreen.step
S&H Management board_PCB.step
