Rutherfurrd/Science-Jubilee-Modular-Equipment-System/(list of files, cad)

Other CAD files:
3D Files/Control Hub/Print Files/Top Panel.STL
3D Files/H&S/Stud.SLDPRT
3D Files/Control Hub/Tab and Slot-Tab20.SLDPRT
3D Files/Control Hub/Boss-Extrude11.SLDPRT
3D Files/Control Hub/Print Files/Rear Panel.STL
3D Files/Control Hub/Body5.SLDPRT
3D Files/Control Hub/Body6.SLDPRT
3D Files/Control Hub/Body8.SLDPRT
3D Files/Control Hub/Body7.SLDPRT
3D Files/H&S/Final Assembly.SLDASM
3D Files/H&S/Motor Housing LID - Copy.SLDPRT
3D Files/H&S/Print Files/Magnet Case.3mf
3D Files/H&S/Print Files/Magnet Case.STL
3D Files/H&S/Print Files/Motor Base.STL
3D Files/H&S/Vial Wells - Copy.SLDPRT
Electrical Files/Hotplate/Heating board.stl
Electrical Files/Hotplate/JLCFH/JLC Step.SLDASM
Electrical Files/Hotplate/JLCFH/JLC Step.SLDDRW
