Rutherfurrd/Science-Jubilee-Modular-Equipment-System/Electrical Files/H&S Module/S&H Management board.kicad_pcb

## KiCad design Electrical Files/H&S Module/S&H Management board.kicad_pcb (2026-08-26)

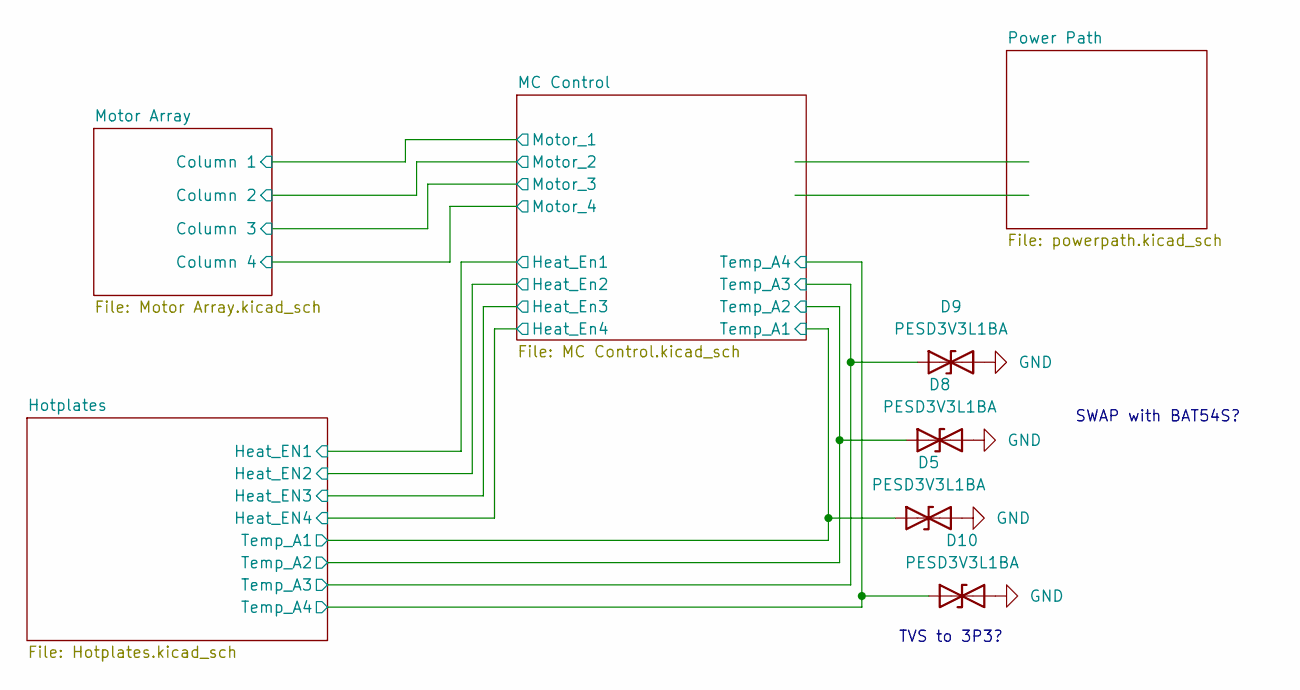
[picture p76: schematic S&H Management board.kicad_sch]

Parts:
D5, D8, D9, D10: PESD3V3L1BA; D_SOD-323F

Connections:
/Hotplates/Temp_A1: D5.1 (A1); also elsewhere on the board
/Hotplates/Temp_A2: D8.1 (A1); also elsewhere on the board
/Hotplates/Temp_A3: D9.1 (A1); also elsewhere on the board
/Hotplates/Temp_A4: D10.1 (A1); also elsewhere on the board
GND: D5.2 (A2), D8.2 (A2), D9.2 (A2), D10.2 (A2); also elsewhere on the board

Notes on the sheet:
SWAP with BAT54S?
TVS to 3P3?

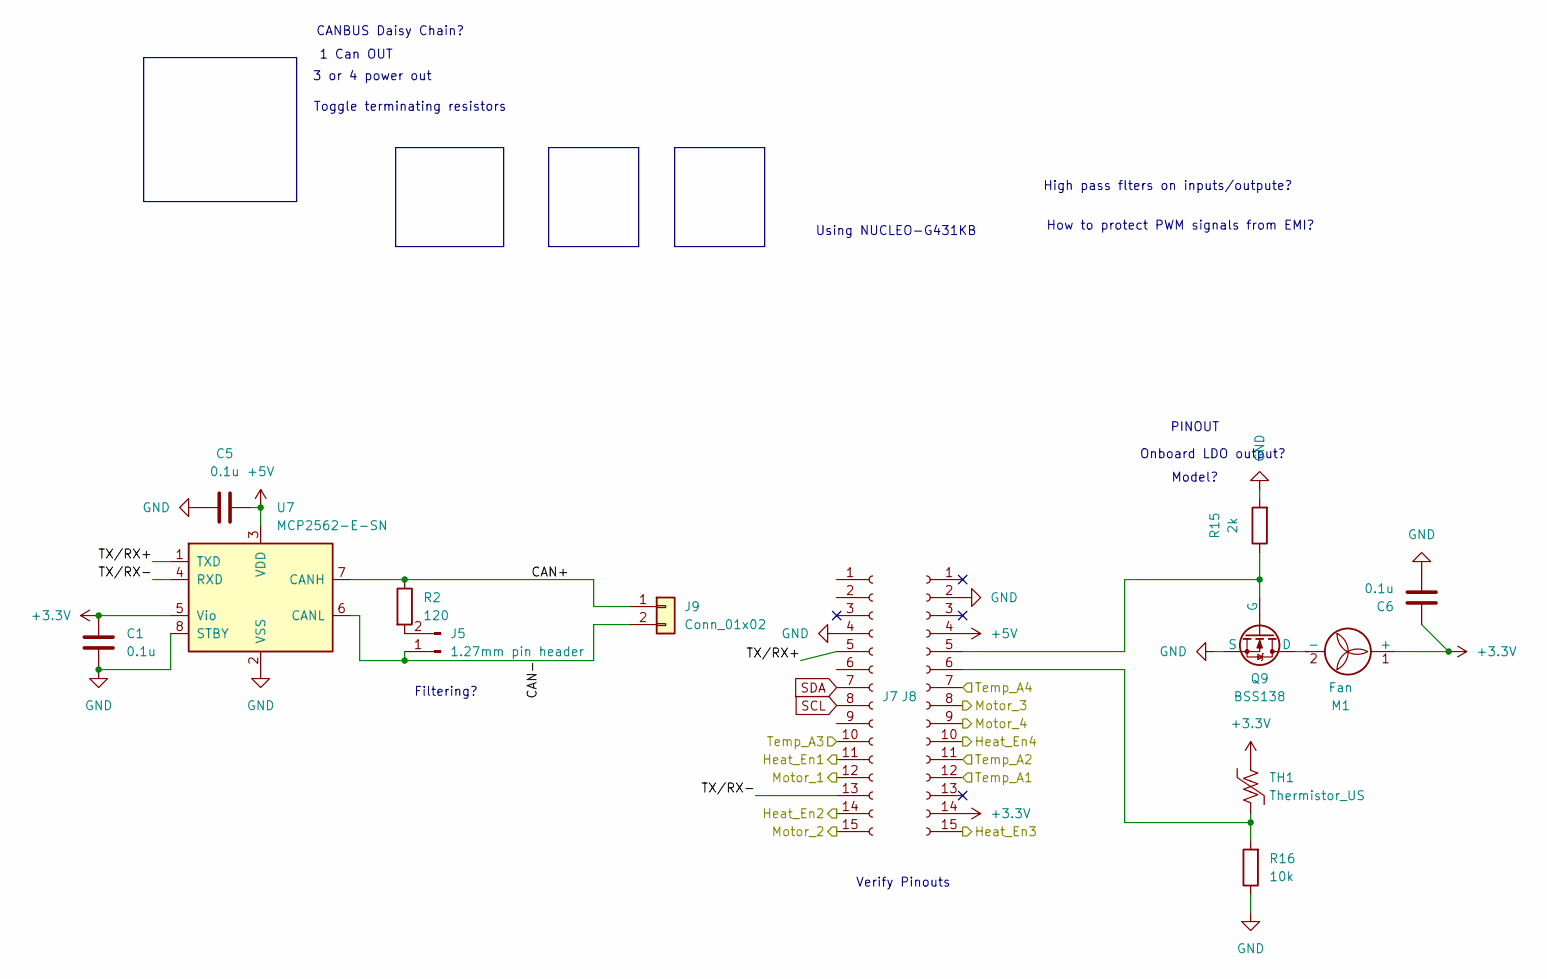
[picture p77: schematic MC Control.kicad_sch]

Parts:
C1, C5, C6: 0.1u; C_0603_1608Metric_Pad1.08x0.95mm_HandSolder
J5: 1.27mm pin header; PinHeader_1x02_P1.27mm_Vertical
J7, J8: PPTC151LFBN-RC; PinHeader_1x15_P2.54mm_Vertical
J9: Conn_01x02; Molex_Mini-Fit_Jr_5569-02A2_2x01_P4.20mm_Horizontal
M1: Fan; JST_PH_B2B-PH-K_1x02_P2.00mm_Vertical
Q9: BSS138; SOT-23-3
R2: 120; R_0603_1608Metric_Pad0.98x0.95mm_HandSolder
R15: 2k; R_0603_1608Metric_Pad0.98x0.95mm_HandSolder
R16: 10k; R_0603_1608Metric_Pad0.98x0.95mm_HandSolder
TH1: Thermistor_US; R_0603_1608Metric_Pad0.98x0.95mm_HandSolder
U7: MCP2562-E-SN; SOIC-8_3.9x4.9mm_P1.27mm; LCSC C124016

Connections:
+3.3V: C1.1, C6.1, J8.14, M1.1 (+), TH1.1, U7.5 (Vio); also elsewhere on the board
+5V: C5.2, J8.4, U7.3 (VDD); also elsewhere on the board
/Hotplates/Heat_EN1: J7.11; also elsewhere on the board
/Hotplates/Heat_EN2: J7.14; also elsewhere on the board
/Hotplates/Heat_EN3: J8.15; also elsewhere on the board
/Hotplates/Heat_EN4: J8.10; also elsewhere on the board
/Hotplates/Temp_A1: J8.12; also elsewhere on the board
/Hotplates/Temp_A2: J8.11; also elsewhere on the board
/Hotplates/Temp_A3: J7.10; also elsewhere on the board
/Hotplates/Temp_A4: J8.7; also elsewhere on the board
/MC Control/CAN+: J9.1, R2.1, U7.7 (CANH)
/MC Control/CAN-: J5.1, J9.2, U7.6 (CANL)
/MC Control/Motor_1: J7.12; also elsewhere on the board
/MC Control/Motor_2: J7.15; also elsewhere on the board
/MC Control/Motor_3: J8.8; also elsewhere on the board
/MC Control/Motor_4: J8.9; also elsewhere on the board
/MC Control/TX/RX+: J7.5, U7.1 (TXD)
/MC Control/TX/RX-: J7.13, U7.4 (RXD)
GND: C1.2, C5.1, C6.2, J7.4, J8.2, Q9.3 (S), R15.2, R16.1, U7.2 (VSS), U7.8 (STBY); also elsewhere on the board
unnamed: J5.2, R2.2
unnamed: J8.5, Q9.2 (G), R15.1
unnamed: J8.6, R16.2, TH1.2
unnamed: M1.2 (-), Q9.1 (D)
SCL: J7.8
SDA: J7.7

Notes on the sheet:
Using NUCLEO-G431KB
PINOUT
High pass flters on inputs/outpute?
Filtering?
3 or 4 power out
Onboard LDO output?
Verify Pinouts
CANBUS Daisy Chain?
Model?
How to protect PWM signals from EMI?
Toggle terminating resistors
1 Can OUT

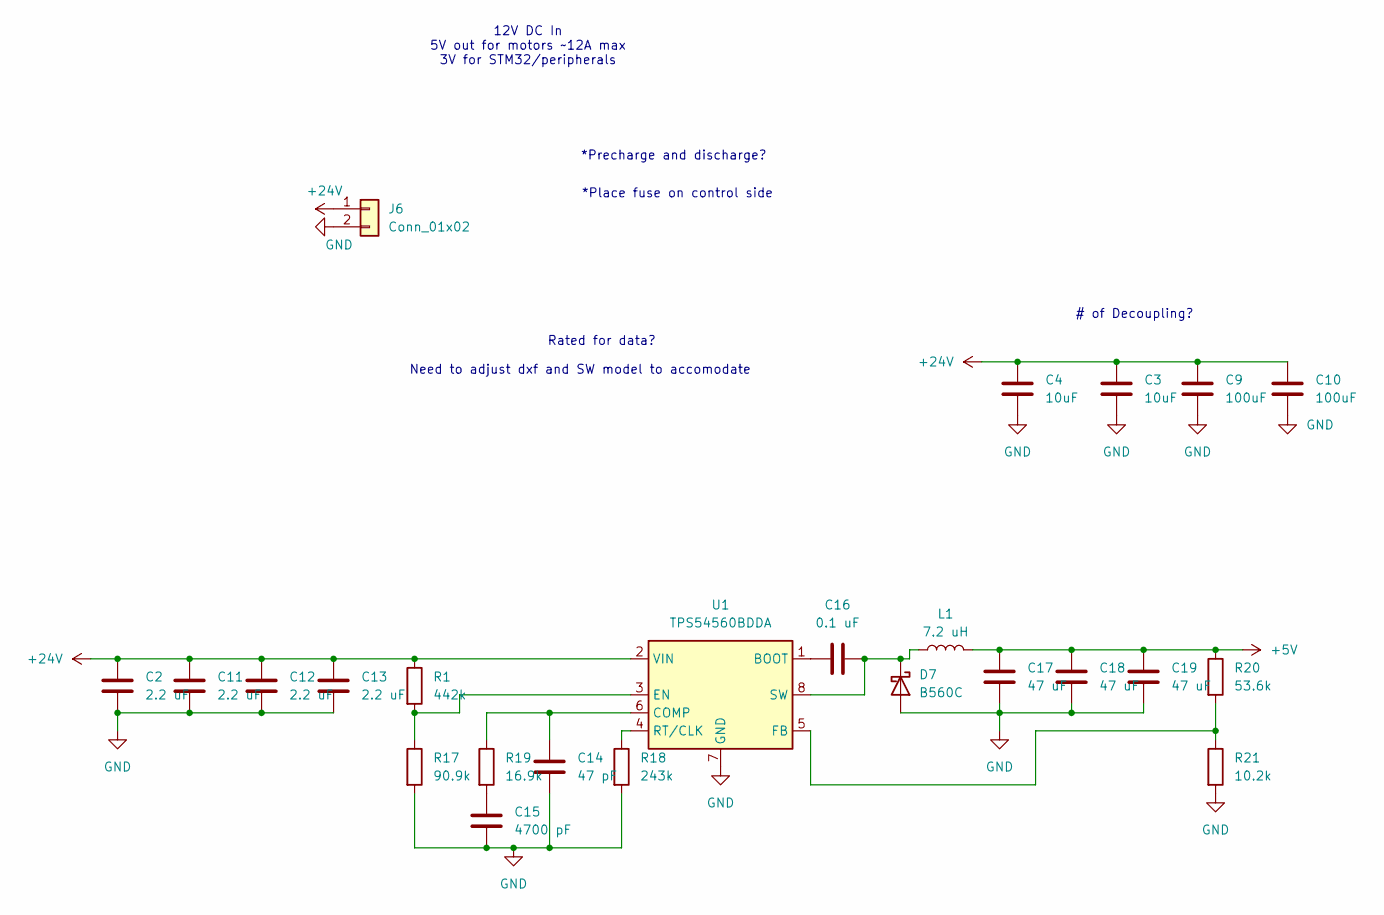
[picture p78: schematic powerpath.kicad_sch]

Parts:
C2, C11, C12, C13: 2.2 uF; C_0603_1608Metric_Pad1.08x0.95mm_HandSolder
C3, C4: 10uF; C_0603_1608Metric_Pad1.08x0.95mm_HandSolder
C9, C10: 100uF; C_0603_1608Metric_Pad1.08x0.95mm_HandSolder
C14: 47 pF; C_0603_1608Metric_Pad1.08x0.95mm_HandSolder
C15: 4700 pF; C_0603_1608Metric_Pad1.08x0.95mm_HandSolder
C16: 0.1 uF; C_0603_1608Metric_Pad1.08x0.95mm_HandSolder
C17, C18, C19: 47 uF; C_0603_1608Metric_Pad1.08x0.95mm_HandSolder
D7: B560C; D_SMC(DO-214AB)
J6: Conn_01x02; Molex_Mini-Fit_Jr_5569-02A2_2x01_P4.20mm_Horizontal
L1: 7.2 uH; L_Bourns_SRP7028A_7.3x6.6mm
R1: 442k; R_0603_1608Metric_Pad0.98x0.95mm_HandSolder
R17: 90.9k; R_0603_1608Metric_Pad0.98x0.95mm_HandSolder
R18: 243k; R_0603_1608Metric_Pad0.98x0.95mm_HandSolder
R19: 16.9k; R_0603_1608Metric_Pad0.98x0.95mm_HandSolder
R20: 53.6k; R_0603_1608Metric_Pad0.98x0.95mm_HandSolder
R21: 10.2k; R_0603_1608Metric_Pad0.98x0.95mm_HandSolder
U1: TPS54560BDDA; Texas_R-PDSO-G8_EP2.95x4.9mm_Mask2.4x3.1mm_ThermalVias

Connections:
+5V: C17.1, C18.1, C19.1, L1.2, R20.1; also elsewhere on the board
+24V: C2.1, C3.1, C4.1, C9.1, C10.1, C11.1, C12.1, C13.1, J6.1, R1.1, U1.2 (VIN); also elsewhere on the board
GND: C2.2, C3.2, C4.2, C9.2, C10.2, C11.2, C12.2, C13.2, C14.2, C15.2, C17.2, C18.2, C19.2, D7.2 (A), J6.2, R17.2, R18.2, R21.2, U1.7 (GND), U1.9 (GND); also elsewhere on the board
unnamed: C15.1, R19.2
unnamed: C16.2, D7.1 (K), L1.1, U1.8 (SW)
unnamed: C16.1, U1.1 (BOOT)
unnamed: C14.1, R19.1, U1.6 (COMP)
unnamed: R1.2, R17.1, U1.3 (EN)
unnamed: R20.2, R21.1, U1.5 (FB)
unnamed: R18.1, U1.4 (RT/CLK)

Notes on the sheet:
12V DC In 5V out for motors ~12A max 3V for STM32/peripherals
Need to adjust dxf and SW model to accomodate
Rated for data?
*Precharge and discharge?
# of Decoupling?
*Place fuse on control side

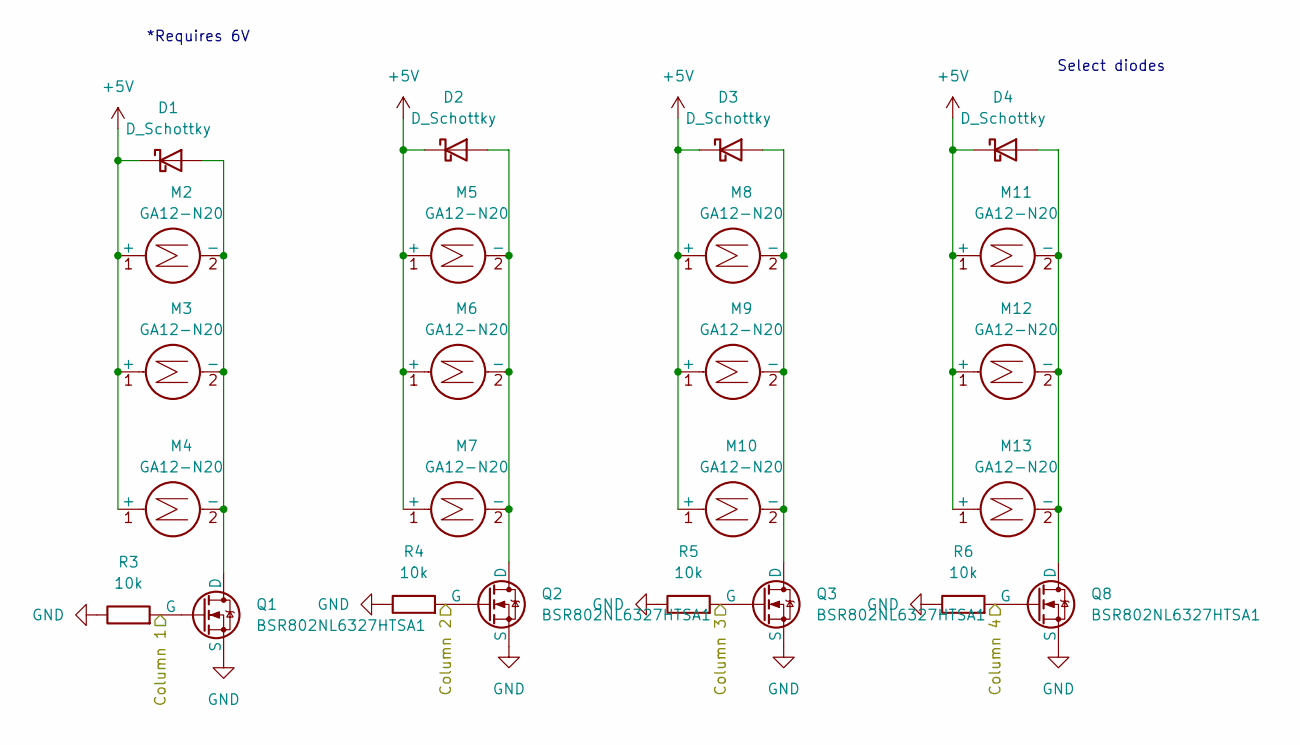
[picture p79: schematic Motor Array.kicad_sch]

Parts:
D1, D2, D3, D4: D_Schottky; D_SOD-323
M2, M3, M4, M5, M6, M7, M8, M9, M10, M11, M12, M13: GA12-N20
Q1, Q2, Q3, Q8: BSR802NL6327HTSA1; SC-59_Handsoldering
R3, R4, R5, R6: 10k; R_0603_1608Metric_Pad0.98x0.95mm_HandSolder

Connections:
+5V: D1.1 (K), D2.1 (K), D3.1 (K), D4.1 (K), M2.1 (+), M3.1 (+), M4.1 (+), M5.1 (+), M6.1 (+), M7.1 (+), M8.1 (+), M9.1 (+), M10.1 (+), M11.1 (+), M12.1 (+), M13.1 (+); also elsewhere on the board
/MC Control/Motor_1: Q1.2 (G), R3.2; also elsewhere on the board
/MC Control/Motor_2: Q2.2 (G), R4.2; also elsewhere on the board
/MC Control/Motor_3: Q3.2 (G), R5.2; also elsewhere on the board
/MC Control/Motor_4: Q8.2 (G), R6.2; also elsewhere on the board
GND: Q1.3 (S), Q2.3 (S), Q3.3 (S), Q8.3 (S), R3.1, R4.1, R5.1, R6.1; also elsewhere on the board
unnamed: D1.2 (A), M2.2 (-), M3.2 (-), M4.2 (-), Q1.1 (D)
unnamed: D2.2 (A), M5.2 (-), M6.2 (-), M7.2 (-), Q2.1 (D)
unnamed: D3.2 (A), M8.2 (-), M9.2 (-), M10.2 (-), Q3.1 (D)
unnamed: D4.2 (A), M11.2 (-), M12.2 (-), M13.2 (-), Q8.1 (D)

Notes on the sheet:
*Requires 6V
Select diodes

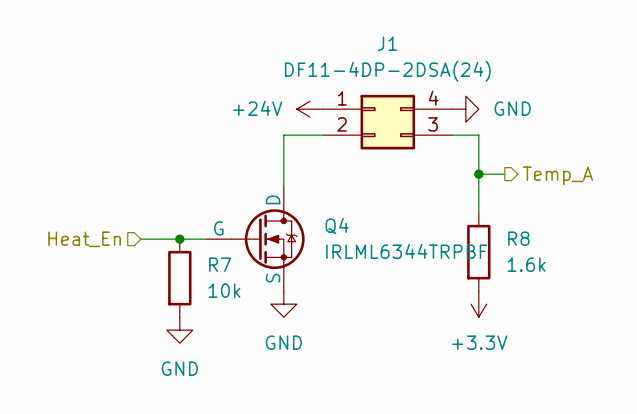
[picture p80: schematic indHotplate.kicad_sch]

Parts:
J1: DF11-4DP-2DSA(24); Hirose_DF11-4DP-2DSA_2x02_P2.00mm_Vertical
Q4: IRLML6344TRPBF; SC-59_Handsoldering
R7: 10k; R_0603_1608Metric_Pad0.98x0.95mm_HandSolder
R8: 1.6k; R_0603_1608Metric_Pad0.98x0.95mm_HandSolder

Connections:
+3.3V: R8.2; also elsewhere on the board
+24V: J1.1; also elsewhere on the board
/Hotplates/Heat_EN1: Q4.2 (G), R7.1; also elsewhere on the board
/Hotplates/Temp_A1: J1.3, R8.1; also elsewhere on the board
GND: J1.4, Q4.3 (S), R7.2; also elsewhere on the board
unnamed: J1.2, Q4.1 (D)

Parts of its further copies:
J2, J3, J4: DF11-4DP-2DSA(24); Hirose_DF11-4DP-2DSA_2x02_P2.00mm_Vertical
Q5, Q6, Q7: IRLML6344TRPBF; SC-59_Handsoldering
R9, R11, R13: 10k; R_0603_1608Metric_Pad0.98x0.95mm_HandSolder
R10, R12, R14: 1.6k; R_0603_1608Metric_Pad0.98x0.95mm_HandSolder

Connections of its further copies:
+3.3V: R10.2, R12.2, R14.2; also elsewhere on the board
+24V: J2.1, J3.1, J4.1; also elsewhere on the board
/Hotplates/Heat_EN2: Q5.2 (G), R9.1; also elsewhere on the board
/Hotplates/Heat_EN3: Q6.2 (G), R11.1; also elsewhere on the board
/Hotplates/Heat_EN4: Q7.2 (G), R13.1; also elsewhere on the board
/Hotplates/Temp_A2: J2.3, R10.1; also elsewhere on the board
/Hotplates/Temp_A3: J3.3, R12.1; also elsewhere on the board
/Hotplates/Temp_A4: J4.3, R14.1; also elsewhere on the board
GND: J2.4, J3.4, J4.4, Q5.3 (S), Q6.3 (S), Q7.3 (S), R9.2, R11.2, R13.2; also elsewhere on the board
unnamed: J2.2, Q5.1 (D)
unnamed: J3.2, Q6.1 (D)
unnamed: J4.2, Q7.1 (D)

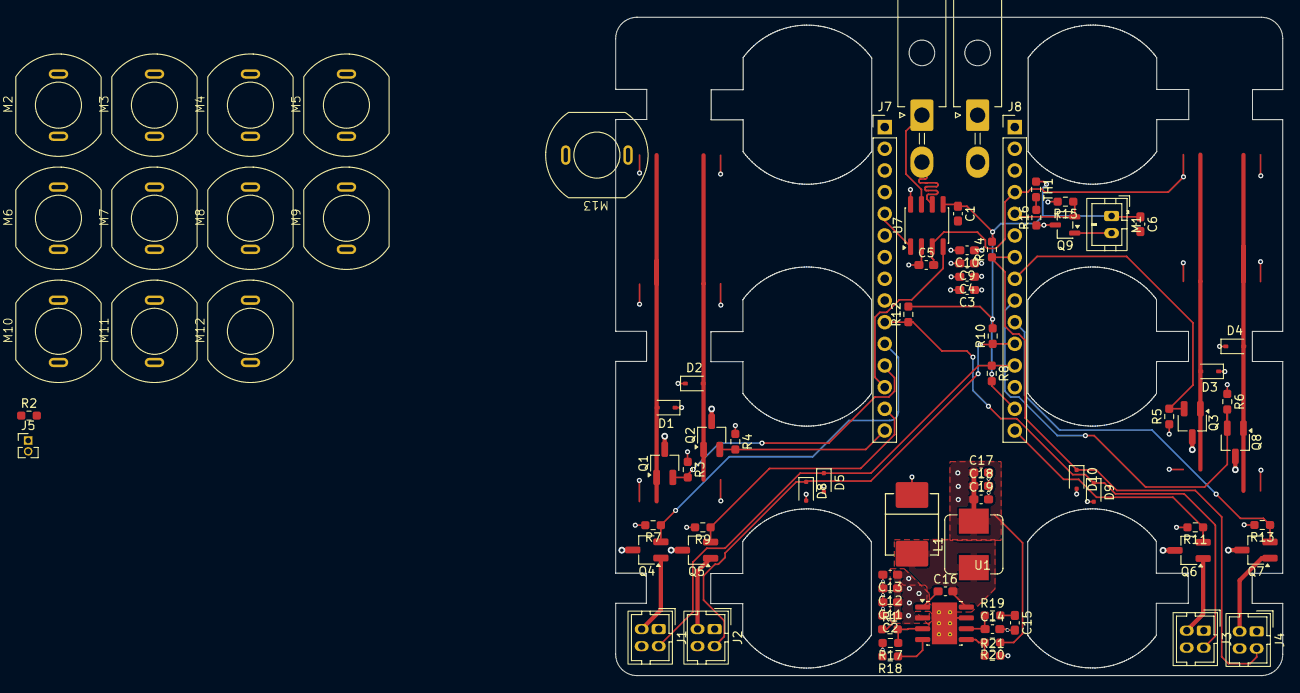
[picture p81: board S&H Management board.kicad_pcb from above]

Board: 4 copper layers, 78.2 x 77.2 mm, 82 parts (0 on the bottom side), 39 nets.
