Rutherfurrd/Science-Jubilee-Modular-Equipment-System/Electrical Files/PS Control Hub/PS Control Hub/PS Control Hub.kicad_pcb

## KiCad design Electrical Files/PS Control Hub/PS Control Hub/PS Control Hub.kicad_pcb (2026-05-28)

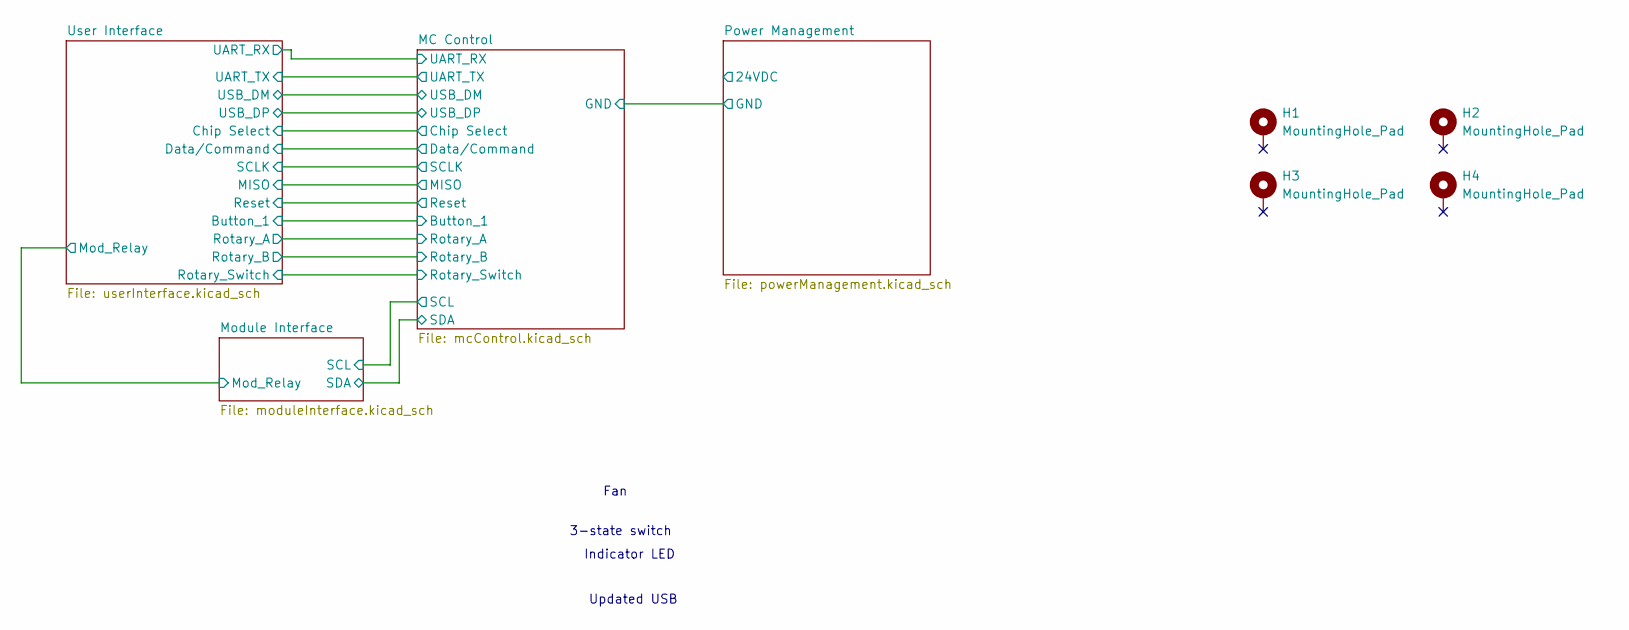
[picture p82: schematic PS Control Hub.kicad_sch]

Parts:
H1, H2, H3, H4: MountingHole_Pad; MountingHole_3.2mm_M3_DIN965_Pad_TopBottom

Notes on the sheet:
Updated USB
Fan
Indicator LED
3-state switch

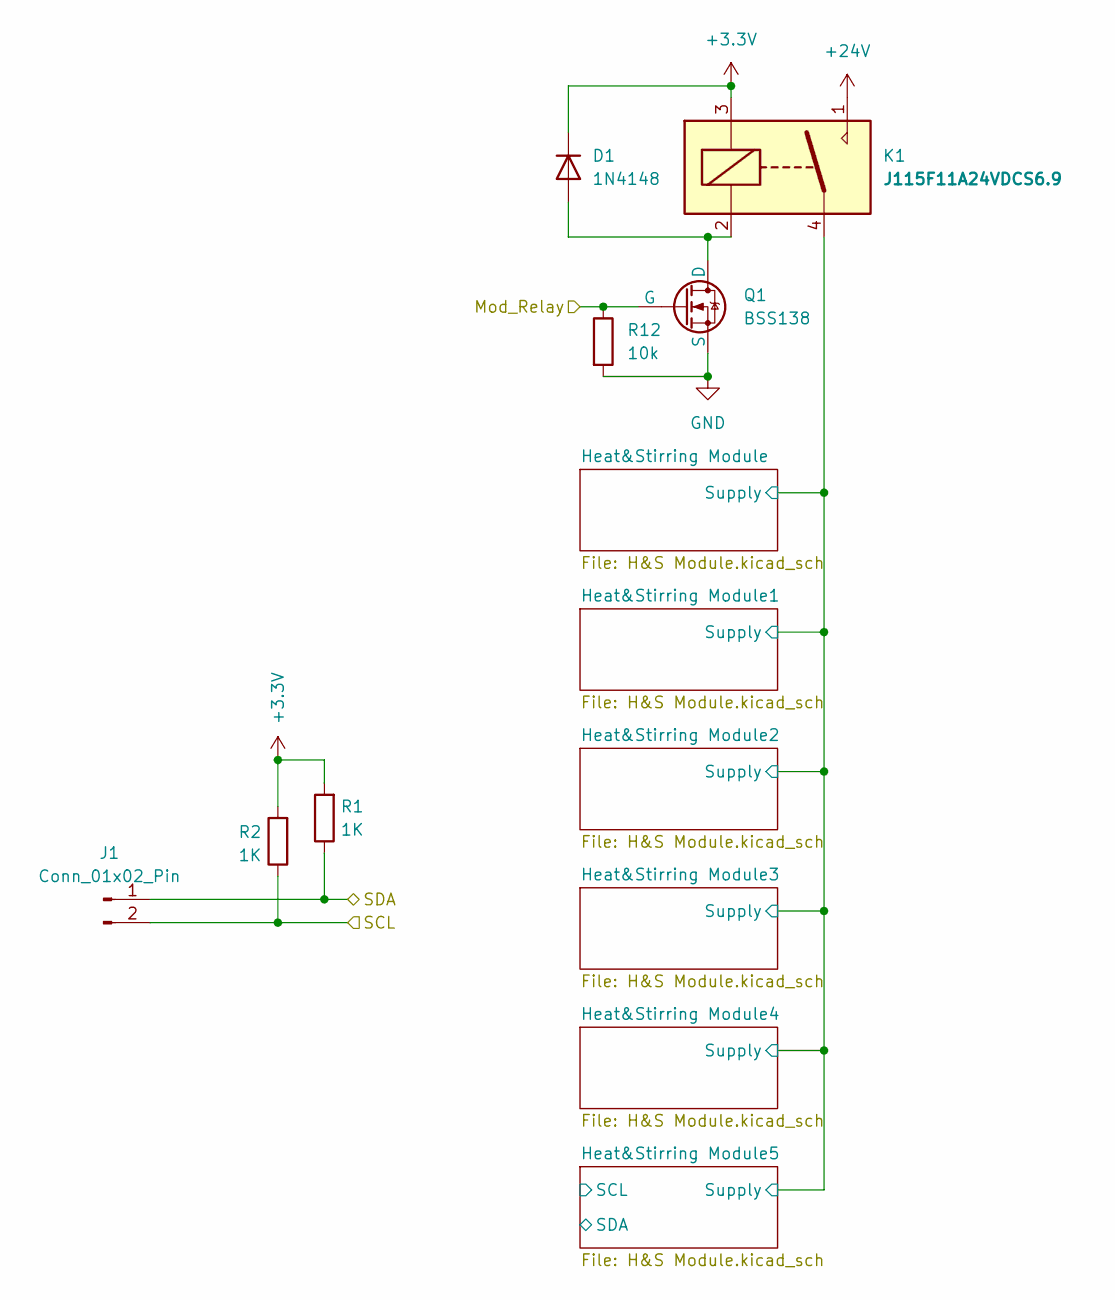
[picture p83: schematic moduleInterface.kicad_sch]

Parts:
D1: 1N4148; D_DO-35_SOD27_P7.62mm_Horizontal
J1: Conn_01x02_Pin; Molex_Mini-Fit_Jr_5566-02A_2x01_P4.20mm_Vertical
K1: J115F11A24VDCS6.9; J115F1_1A_S_6_CRS
Q1: BSS138; SOT-23-3
R1, R2: 1K; R_0805_2012Metric_Pad1.20x1.40mm_HandSolder
R12: 10k; R_0805_2012Metric_Pad1.20x1.40mm_HandSolder

Connections:
+3.3V: D1.1 (K), K1.3, R1.2, R2.2; also elsewhere on the board
+24V: K1.1; also elsewhere on the board
/MC Control/SCL: J1.2, R2.1; also elsewhere on the board
/MC Control/SDA: J1.1, R1.1; also elsewhere on the board
/Module Interface/Heat&Stirring Module/Supply: K1.4; also elsewhere on the board
/Module Interface/Mod_Relay: Q1.2 (G), R12.1; also elsewhere on the board
GND: Q1.3 (S), R12.2; also elsewhere on the board
unnamed: D1.2 (A), K1.2, Q1.1 (D)

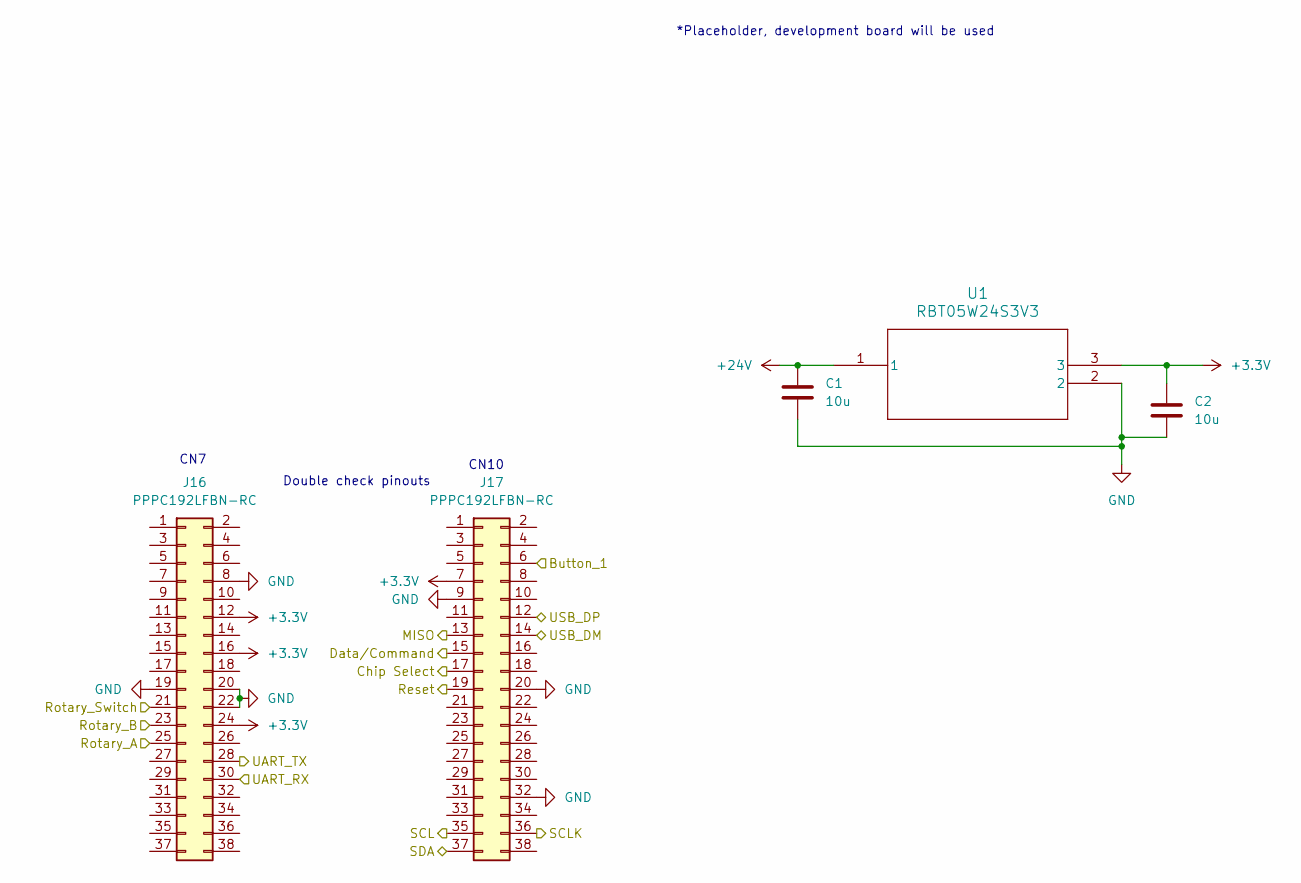
[picture p84: schematic mcControl.kicad_sch]

Parts:
C1, C2: 10u; C_0805_2012Metric_Pad1.18x1.45mm_HandSolder
J16, J17: PPPC192LFBN-RC; PinSocket_2x19_P2.54mm_Vertical
U1: RBT05W24S3V3; RBT10W24S05_XPP_XPR

Connections:
+3.3V: C2.1, J16.12, J16.16, J16.24, J17.7, U1.3; also elsewhere on the board
+24V: C1.1, U1.1; also elsewhere on the board
/MC Control/Button_1: J17.6; also elsewhere on the board
/MC Control/Chip Select: J17.17; also elsewhere on the board
/MC Control/Data/Command: J17.15; also elsewhere on the board
/MC Control/MISO: J17.13; also elsewhere on the board
/MC Control/Reset: J17.19; also elsewhere on the board
/MC Control/Rotary_A: J16.25; also elsewhere on the board
/MC Control/Rotary_B: J16.23; also elsewhere on the board
/MC Control/Rotary_Switch: J16.21; also elsewhere on the board
/MC Control/SCL: J17.35; also elsewhere on the board
/MC Control/SCLK: J17.36; also elsewhere on the board
/MC Control/SDA: J17.37; also elsewhere on the board
/MC Control/UART_RX: J16.30; also elsewhere on the board
/MC Control/UART_TX: J16.28; also elsewhere on the board
/MC Control/USB_DM: J17.14
/MC Control/USB_DP: J17.12
GND: C1.2, C2.2, J16.8, J16.19, J16.20, J16.22, J17.9, J17.20, J17.32, U1.2; also elsewhere on the board

Notes on the sheet:
Double check pinouts
*Placeholder, development board will be used
CN10
CN7

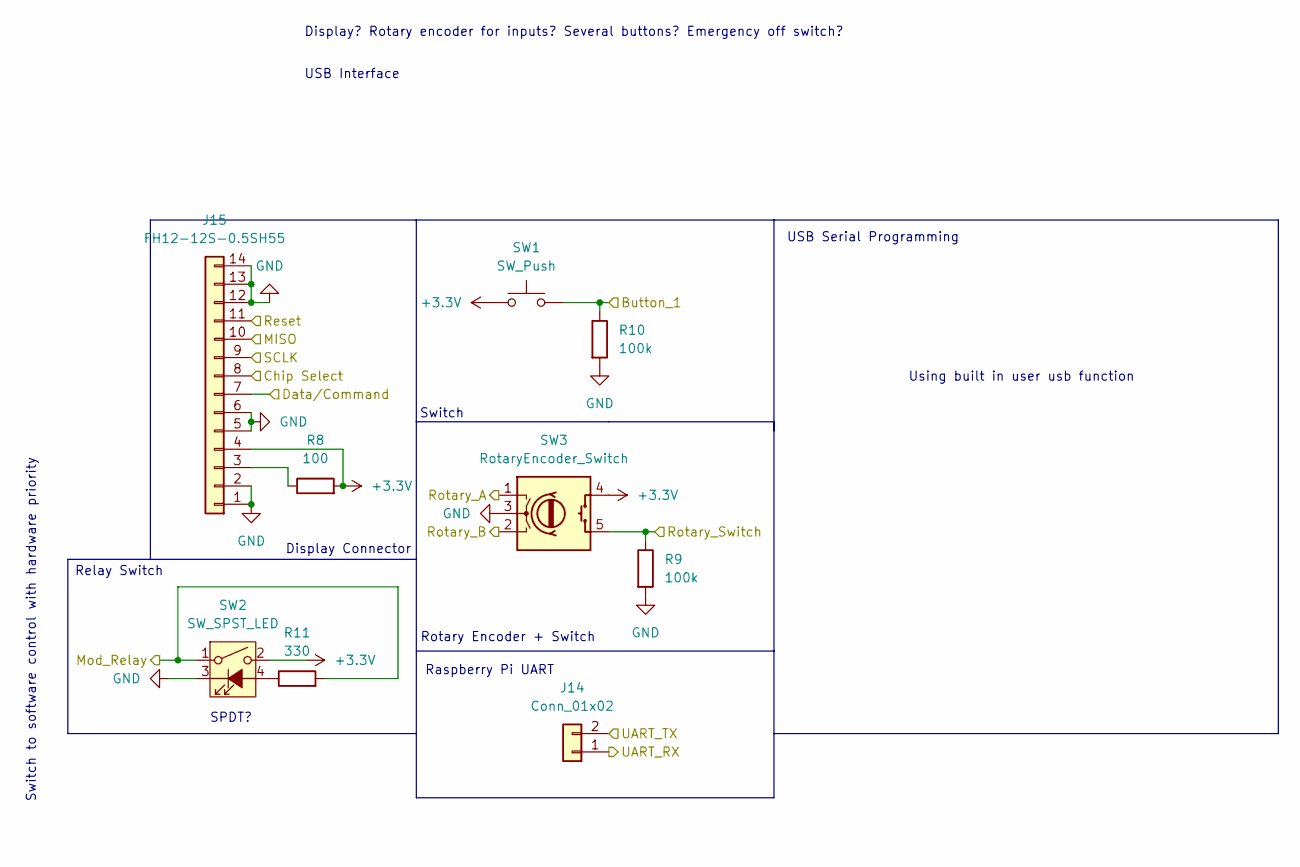
[picture p85: schematic userInterface.kicad_sch]

Parts:
J14: Conn_01x02; Molex_Mini-Fit_Jr_5566-02A_2x01_P4.20mm_Vertical
J15: FH12-12S-0.5SH55
R8: 100; R_0805_2012Metric_Pad1.20x1.40mm_HandSolder
R9, R10: 100k; R_0805_2012Metric_Pad1.20x1.40mm_HandSolder
R11: 330; R_0805_2012Metric_Pad1.20x1.40mm_HandSolder
SW1: SW_Push; JST_PH_B2B-PH-K_1x02_P2.00mm_Vertical
SW2: SW_SPST_LED; JST_PH_B4B-PH-K_1x04_P2.00mm_Vertical
SW3: RotaryEncoder_Switch; JST_PH_B5B-PH-K_1x05_P2.00mm_Vertical

Connections:
+3.3V: J15.4, R8.2, SW1.1, SW2.2, SW3.4 (S1); also elsewhere on the board
/MC Control/Button_1: R10.1, SW1.2; also elsewhere on the board
/MC Control/Chip Select: J15.8; also elsewhere on the board
/MC Control/Data/Command: J15.7; also elsewhere on the board
/MC Control/MISO: J15.10; also elsewhere on the board
/MC Control/Reset: J15.11; also elsewhere on the board
/MC Control/Rotary_A: SW3.1 (A); also elsewhere on the board
/MC Control/Rotary_B: SW3.2 (B); also elsewhere on the board
/MC Control/Rotary_Switch: R9.1, SW3.5 (S2); also elsewhere on the board
/MC Control/SCLK: J15.9; also elsewhere on the board
/MC Control/UART_RX: J14.1; also elsewhere on the board
/MC Control/UART_TX: J14.2; also elsewhere on the board
/Module Interface/Mod_Relay: R11.2, SW2.1; also elsewhere on the board
GND: J15.1, J15.2, J15.5, J15.6, J15.12, J15.13, J15.14, R9.2, R10.2, SW2.3 (K), SW3.3 (C); also elsewhere on the board
unnamed: J15.3, R8.1
unnamed: R11.1, SW2.4 (A)

Notes on the sheet:
Switch
USB Serial Programming
Display? Rotary encoder for inputs? Several buttons? Emergency off switch?
Relay Switch
Raspberry Pi UART
USB Interface
Display Connector
Rotary Encoder + Switch
Switch to software control with hardware priority
Using built in user usb function
SPDT?

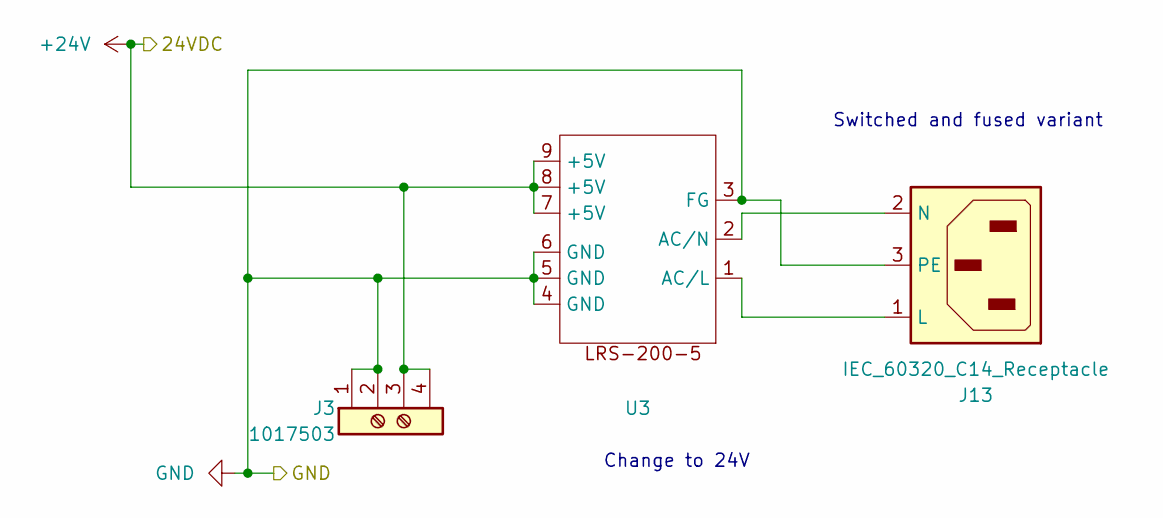
[picture p86: schematic powerManagement.kicad_sch]

Parts:
J3: 1017503; CONN_1017491
J13: IEC_60320_C14_Receptacle
U3: (no value)

Connections:
+24V: J3.3 (Pin_2), J3.4 (Pin_2), U3.7 (+5V), U3.8 (+5V), U3.9 (+5V); also elsewhere on the board
GND: J3.1, J3.2 (Pin_1), J13.3 (PE), U3.3 (FG), U3.4 (GND), U3.5 (GND), U3.6 (GND); also elsewhere on the board
unnamed: J13.1 (L), U3.1 (AC/L)
unnamed: J13.2 (N), U3.2 (AC/N)

Notes on the sheet:
Switched and fused variant
Change to 24V

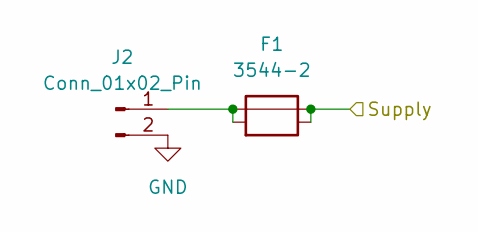
[picture p87: schematic H&S Module.kicad_sch]

Parts:
F1: 3544-2; CONN_3544-2_KEY
J2: Conn_01x02_Pin; Molex_Mini-Fit_Jr_5566-02A_2x01_P4.20mm_Vertical

Connections:
/Module Interface/Heat&Stirring Module/Supply: F1.3, F1.4; also elsewhere on the board
GND: J2.2; also elsewhere on the board
unnamed: F1.1, F1.2, J2.1

Parts of its further copies:
F2, F3, F4, F5, F6: 3544-2; CONN_3544-2_KEY
J4, J6, J8, J10, J12: Conn_01x02_Pin; Molex_Mini-Fit_Jr_5566-02A_2x01_P4.20mm_Vertical

Connections of its further copies:
/Module Interface/Heat&Stirring Module/Supply: F2.3, F2.4, F3.3, F3.4, F4.3, F4.4, F5.3, F5.4, F6.3, F6.4; also elsewhere on the board
GND: J4.2, J6.2, J8.2, J10.2, J12.2; also elsewhere on the board
unnamed: F2.1, F2.2, J4.1
unnamed: F3.1, F3.2, J6.1
unnamed: F4.1, F4.2, J8.1
unnamed: F5.1, F5.2, J10.1
unnamed: F6.1, F6.2, J12.1

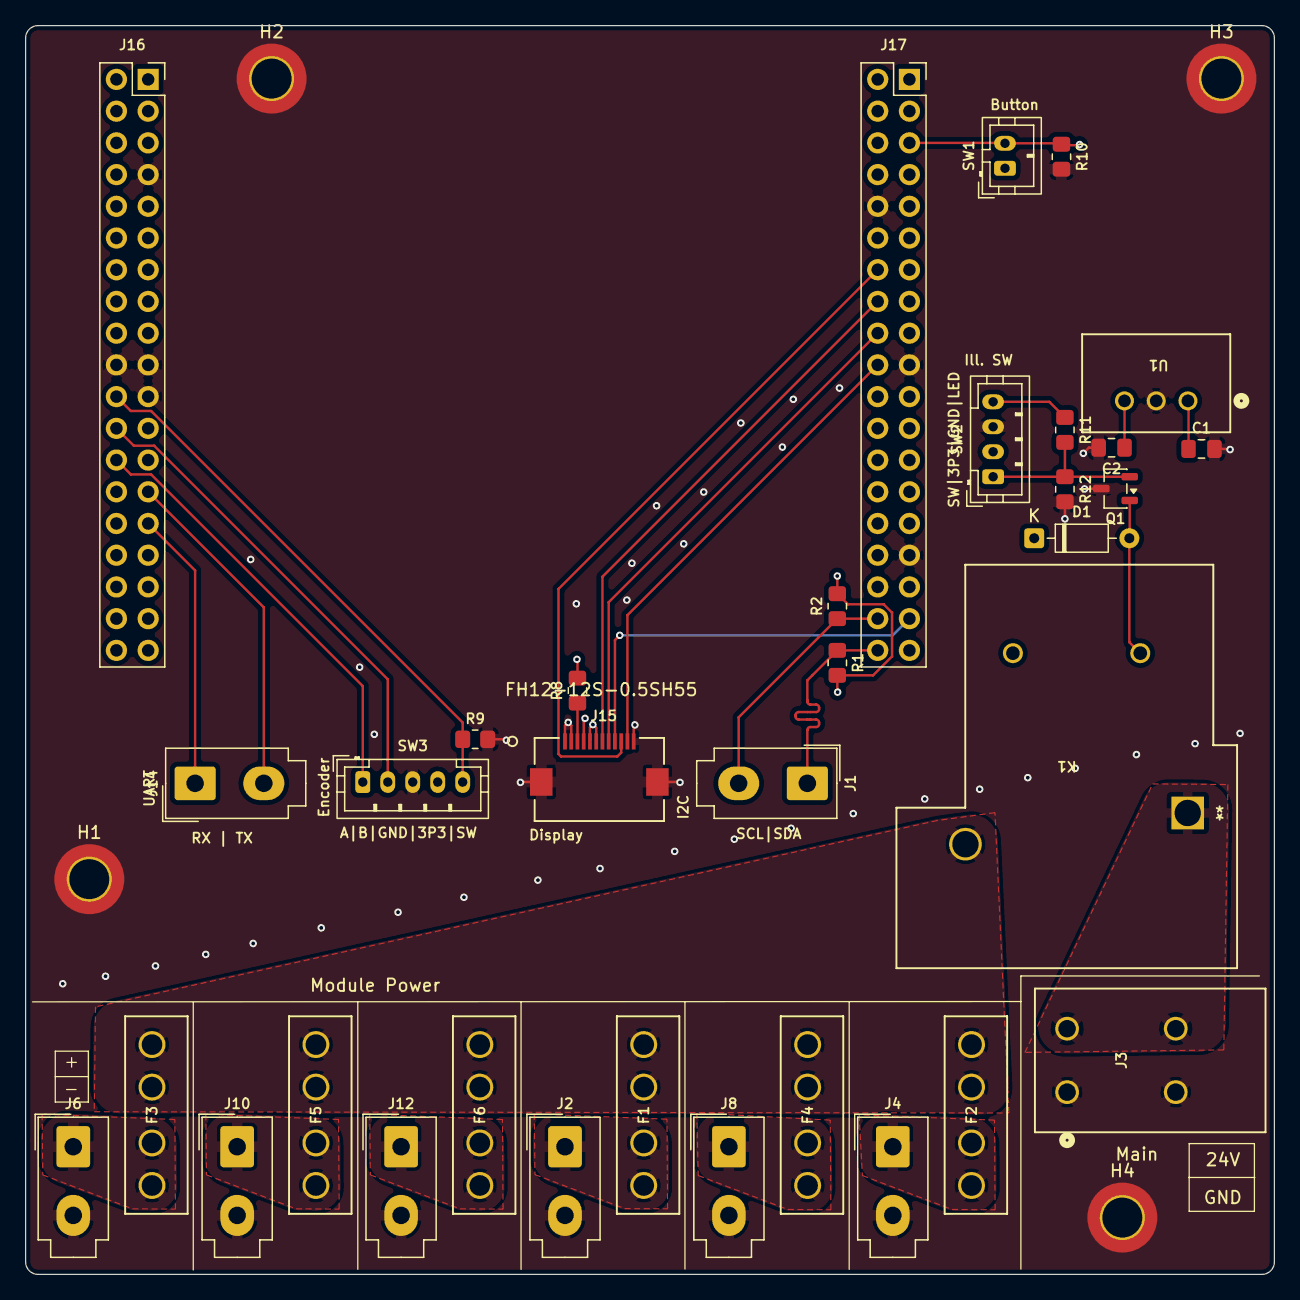
[picture p88: board PS Control Hub.kicad_pcb from above]

Board: 4 copper layers, 100.0 x 100.0 mm, 38 parts (0 on the bottom side), 27 nets.
