Rutherfurrd/Science-Jubilee-Modular-Equipment-System/Electrical Files/Hotplate/Heating board.kicad_pcb

## KiCad design Electrical Files/Hotplate/Heating board.kicad_pcb (2026-04-16)

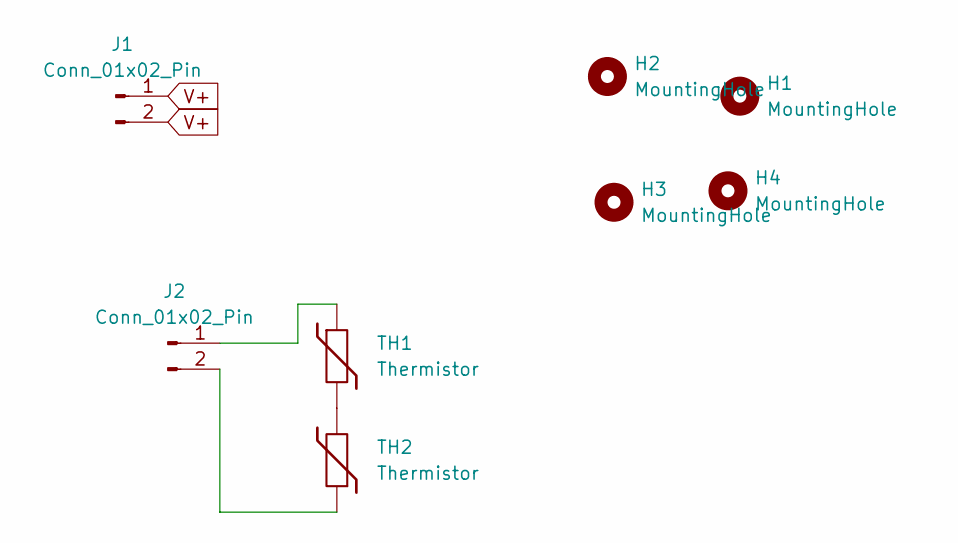
[picture p89: schematic Heating board.kicad_sch]

Parts:
H1, H2, H3, H4: MountingHole; MountingHole_2.2mm_M2_DIN965_Pad_TopBottom
J1, J2: Conn_01x02_Pin; SolderWire-0.1sqmm_1x02_P3.6mm_D0.4mm_OD1mm
TH1: Thermistor; C_0603_1608Metric_Pad1.08x0.95mm_HandSolder
TH2: Thermistor; R_0603_1608Metric_Pad0.98x0.95mm_HandSolder

Connections:
unnamed: J2.1, TH1.1
unnamed: J2.2, TH2.1
unnamed: TH1.2, TH2.2
V+: J1.1, J1.2

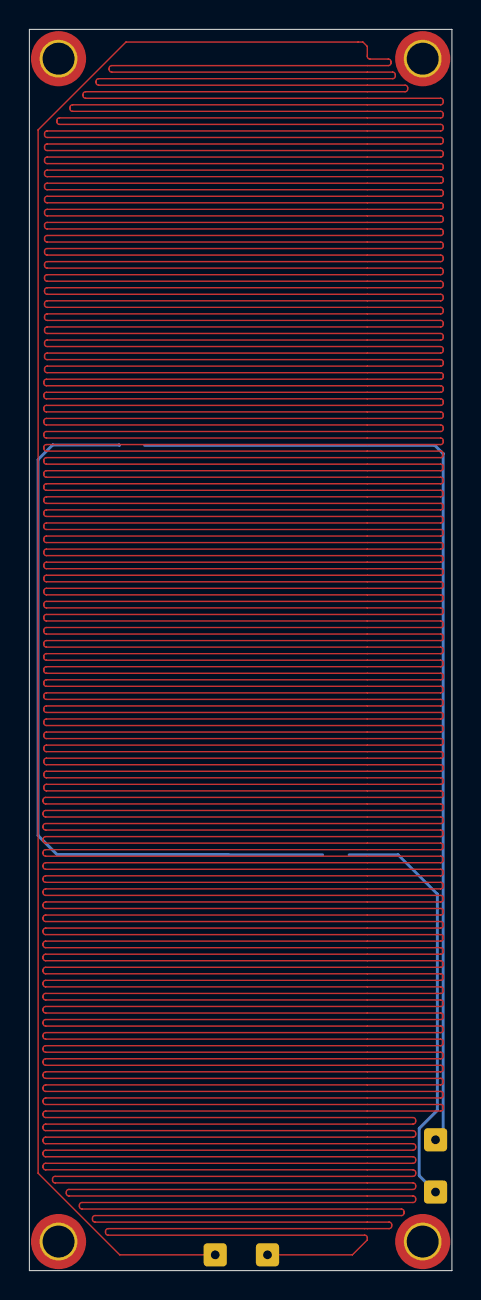
[picture p90: board Heating board.kicad_pcb from above]

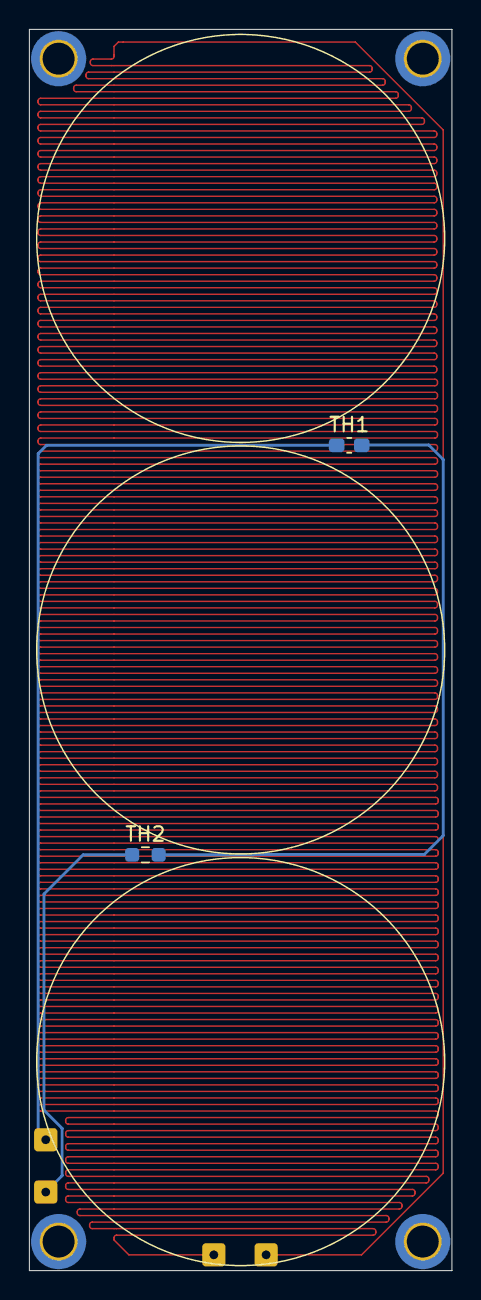
[picture p91: board Heating board.kicad_pcb from below]

Board: 2 copper layers, 29.1 x 85.5 mm, 8 parts (2 on the bottom side), 4 nets.
