Rutherfurrd/Science-Jubilee-Modular-Equipment-System/Firmware/PWM Test/PWM Test.ioc

Mcu.UserName=STM32C071RBTx
PA13.GPIO_Label=SWDIO
PA13.Signal=DEBUG_SWDIO
PA14-BOOT0.GPIO_Label=SWCLK
PA14-BOOT0.Signal=DEBUG_SWCLK
PA2.Signal=USART2_TX
PA3.Signal=USART2_RX
PC14-OSCX_IN(PC14).GPIO_Label=OSCX_IN
PC14-OSCX_IN(PC14).Signal=RCC_OSCX_IN
PC15-OSCX_OUT(PC15).GPIO_Label=OSCX_OUT
PC15-OSCX_OUT(PC15).Signal=RCC_OSCX_OUT
PC8.Signal=S_TIM1_CH1
PF0-OSC_IN(PF0).GPIO_Label=OSC_IN
PF0-OSC_IN(PF0).Signal=RCC_OSC_IN
PF1-OSC_OUT(PF1).GPIO_Label=OSC_OUT
PF1-OSC_OUT(PF1).Signal=RCC_OSC_OUT
