Rutherfurrd/Science-Jubilee-Modular-Equipment-System/(commit log)

2026-03-13 Control Hub Housing
    [Bill of Materials.xlsx, MC Control.kicad_sch, Power Supply Chassis.SLDPRT]
2026-04-16 Control Hub Housing, H&S PCB
    [Bill of Materials.xlsx, Body1.SLDPRT, Body10.SLDPRT, Body2.SLDPRT, Body3.SLDPRT, Body4.SLDPRT, Body5.SLDPRT, Body6.SLDPRT]
2026-05-28 Control Hub, Flexible Hotplate, Housing Fan
    [Assembly.SLDASM, Boss-Extrude11.SLDPRT, Bottom Panel.STL, Button Interface.STL, FinalAssemblyV2.SLDASM, Flexible Heater.kicad_pcb, Flexible Heater.kicad_sch, Front Grille.STL]
2026-08-26 New motor
    [Motor Array.kicad_sch, S&H Management board.kicad_pcb]
