Rutherfurrd/Science-Jubilee-Modular-Equipment-System/(notices)

Notices in the files:
Firmware/PWM Test/Core/Src/main.c:
Copyright (c) 2026 STMicroelectronics.
All rights reserved.
This software is licensed under terms that can be found in the LICENSE file
parts and their libraries:
Copyright 2016 Accelerated Designs. All rights reserved.
